KudoC0nan/Balance_On_Wheels/CAD_Designs/Prototype/Design.md

## Design Timeline
<h4>Old design for Case</h4>
<p>It contained curved structures and an additional platform on top for the SRA board<br>
Our second design was modeled in the same way and modified from there accordingly</p>
<image src="assets\Pic1.png"><br>

<p>The new changes made to the design were to make the surfaces flat and reduce the number of unncecssary structures that would cause manufacturing difficulties</p>
<image src="assets\Old.png"><br>
<p>The old leg design contained unneccesary curves which pu strain on their structure. Along with that the joints in the old design were not proper as well</p>
<image src="assets\Pic2.png"><br>
  <p>The motor used for this project is the N20 motor</p>
  <image src="assets\n20.png"><br>
    <p>We went with wheel used in our Wall-E project as wheels for this bot</p>
    <image src="assets\wheel.png"><br>
<p>Along with eliminating the curves, a sandwich leg design is implemented</p>
<image src="assets\bot.png"><br>
<p>New design with Flat casing</p>
<image src="assets\Top.png"><br>
