KudoC0nan/Balance_On_Wheels/Notes/Arsh Notes/pwm.md

# PWM (Pulse Width Modulation)
---
**Pulse-width modulation (PWM)**, or pulse-duration modulation (PDM), is a method of reducing the average power delivered by an electrical signal, by effectively chopping it up into discrete parts. 
Pulse Width Modulation, or PWM, is a technique for getting analog results with digital means. 
The average value of voltage (and current) fed to the load is controlled by turning the switch between supply and load on and off at a fast rate. The longer the switch is on compared to the off periods, the higher the total power supplied to the load.



#Terms Related to PWM


There are various terms related with the Pulse Width Modulation:-

**Off-Time**
 Duration of time period when the signal is low.
**ON-Time** 
Duration of time period when the signal is high.
**Duty cycle** 
It is the percentage of the time period when the signal remains ON during the period of the pulse width modulation signal.
**Period** 
It is the sum of off-time and on-time of pulse width modulation signal.

## Duty Cycle
Duty cycle is the ratio of time a load or circuit is ON compared to the time the load or circuit is OFF. Duty cycle, sometimes called "duty factor," is expressed as a percentage of ON time. 


Example : A 60% duty cycle is a signal that is ON 60% of the time and OFF the other 40% of time.

Duty Cycle Examples

## Period
Period is a sum of both on and off times and period is calculated as shown in the equation below, where Toff represents the off-time and Ton represents the on-time of a signal.
Formula for calculating Period

#Applications of PWM
**PWM signals can be used for wide variety of applications**
1] PWM Techniques are used in Telecommunications for encoding purposes.

2] Pulse Width Modulation finds its use in controlling Brightness in Smart Lighting Systems 

3] PWM-controlled device that clamps down hard on something.

4] Pin PWM header fan that helps to dissipate the heat from the motherboard.

5] Using the PWM technique and the switching mechanism we can control analog using the digital signal.

6] Pulse Width Modulation is also used to controls the speed of motors.
    (The speed of a DC motor can be controlled by varying its input voltage, i.e. by using PWM.The higher the duty cycle, the greater the average voltage being applied to the dc motor(High Speed) and the lower the duty cycle, the less the average voltage being applied to the dc motor(Low Speed)).

7] Pulse Width Modulation is used as a Volatge Regulator



## Types of PWM
**1] Light Emitting Diode PWM (LEDPWM)**
LEDPWM has low and high speed mode and provides low (8-bit) resolution.

**2] Motor Controlled PWM (MCPWM)**
MCPWM has limited speed and provides high(16-bit) resolution.
Which means that mcpwm will count from 0 to (2^16)-1 in 1 sec i.e. 0 to 65535 in 1 sec.
It has two MCPWM peripherals. Each has 3 pairs of pwm output and can be used to control various types of motors.

![]()

---
#CODE

```C
#include <stdio.h>
#include <math.h>
#include <time.h>
#include <string.h>
#include <stdlib.h>

//Components
#include "sra_board.h"

// Select the mode needed by uncommenting its definition
#define MODE NORMAL_MODE
// #define MODE PARALLEL_MODE

void pwm_task(void *arg)
{

	if (MODE == NORMAL_MODE)
	{
		enable_motor_driver(a, NORMAL_MODE); // Enable motor driver A in Normal Mode

		// Make the Motors go forward & backward alternatively, at different PWM from 60 to 100
		while (1)
		{
			for (int duty_cycle = 60; duty_cycle <= 100; duty_cycle++)
			{
				// setting motor speed of MOTOR A0 in forward direction with duty cycle
				set_motor_speed(MOTOR_A_0, MOTOR_FORWARD, duty_cycle);

				// setting motor speed of MOTOR A1 in forward direction with duty cycle
				set_motor_speed(MOTOR_A_1, MOTOR_FORWARD, duty_cycle);

				// adding delay of 100ms
				vTaskDelay(100 / portTICK_PERIOD_MS);
			}

			// stopping the MOTOR A0
			set_motor_speed(MOTOR_A_0, MOTOR_STOP, 0);

			// stopping the MOTOR A1
			set_motor_speed(MOTOR_A_1, MOTOR_STOP, 0);

			// adding delay of 100ms
			vTaskDelay(100 / portTICK_PERIOD_MS);

			for (int duty_cycle = 60; duty_cycle <= 100; duty_cycle++)
			{
				// setting motor speed of MOTOR A0 in backward direction with duty cycle
				set_motor_speed(MOTOR_A_0, MOTOR_BACKWARD, duty_cycle);

				// setting motor speed of MOTOR A1 in backward direction with duty cycle
				set_motor_speed(MOTOR_A_1, MOTOR_BACKWARD, duty_cycle);

				// adding delay of 100ms
				vTaskDelay(100 / portTICK_PERIOD_MS);
			}

			// stopping the MOTOR A0
			set_motor_speed(MOTOR_A_0, MOTOR_STOP, 0);

			// stopping the MOTOR A1
			set_motor_speed(MOTOR_A_1, MOTOR_STOP, 0);

			// adding delay of 100ms
			vTaskDelay(100 / portTICK_PERIOD_MS);
		}
	}

	else if (MODE == PARALLEL_MODE)
	{
		enable_motor_driver(a, PARALLEL_MODE); // Enable motor driver A in Parallel Mode

		// Make the Motors go forward & backward alternatively, at different PWM from 60 to 100
		while (1)
		{
			for (int duty_cycle = 60; duty_cycle <= 100; duty_cycle++)
			{
				// setting motor speed of motor A in forward direction with duty cycle
				set_motor_speed(MOTOR_A_0, MOTOR_FORWARD, duty_cycle);

				// adding delay of 100ms
				vTaskDelay(100 / portTICK_PERIOD_MS);
			}

			// stopping the motor A
			set_motor_speed(MOTOR_A_0, MOTOR_STOP, 0);

			// adding delay of 100ms
			vTaskDelay(100 / portTICK_PERIOD_MS);

			for (int duty_cycle = 60; duty_cycle <= 100; duty_cycle++)
			{
				// setting motor speed of motor A in backward direction with duty cycle
				set_motor_speed(MOTOR_A_0, MOTOR_BACKWARD, duty_cycle);

				// adding delay of 100ms
				vTaskDelay(100 / 10);
			}

			// stopping the motor A
			set_motor_speed(MOTOR_A_0, MOTOR_STOP, 0);

			// adding delay of 100ms
			vTaskDelay(100 / portTICK_PERIOD_MS);
		}
	}
}
void app_main()
{
	// Basic Function for task creation
	xTaskCreate(&pwm_task, "pwm_task", 4096, NULL, 1, NULL);
}
```
## Expalanation

In `components/sra-board-component/src/motor_driver.c` you can see that the frequency is set to be 20KHz.
In the example duty cycle goes from 60 to 100 and then 0 and then from 60 to 100 in opposite direction for both  the modes.
For one pulse it takes 1/20 KHz secs i.e. 5x10^-5 sec (50 µs) 60% duty cycle means it will be on for 3x10^-5 sec  (30 µs ) and off for 100/(80 x 10^-6 ) i.e 1.25 µs + 20 µs .In the next iteration the value of duty cycle increases and in the last it becomes 100 % which means that signal is high for 5  µs and then a delay again for 1.25 µs. Same in opposite direction.

---

## Header Files

1] `#include<math.h>`
The math.h header defines various mathematical functions and one macro. 
2] `#include <time.h>`
The time.h header defines four variable types, two macro and various functions for manipulating date and time.
3] `#include <string.h>`
The string.h header defines one variable type, one macro, and various functions for manipulating arrays of characters.
4] `#include <stdlib.h>`
The stdlib.h header defines four variable types, several macros, and various functions for performing general functions.
5] `include "sra_board.h"`
Includes components of Sra Board
6] `#define MODE NORMAL_MODE`
Defining a macro, mode as normal_mode

## Functions

1] `enable_motor_driver(a,NORMAL_MODE) or enable_motor_driver(a,NORMAL_MODE)`

`esp_err_t enable_motor_driver_a(int mode)`	

Enables Motor driver A in Parallel or Normal Mode.

**Parameters**
mode : if mode = 1 is passed, motor driver is operated in parallel mode, if mode = 2 is passed, motor driver is operated in normal mode

**Returns** 
esp_err_t returns ESP_OK if motor driver initialised properly, else it returns ESP_ERR_INVALID_ARG

`esp_err_t enable_motor_driver_b(int mode)`	

Enables Motor driver B in Parallel or Normal Mode.

**Parameters**
mode : if mode = 1 is passed, motor driver is operated in parallel mode, if mode = 2 is passed, motor driver is operated in normal mode

**Returns** 
esp_err_t returns ESP_OK if motor driver initialised properly, else it returns ESP_ERR_INVALID_ARG

2] `set_motor_speed()`

Set the speed of motors.

**Syntax**
`esp_err_t set_motor_speed (int motor_id,int direction,float duty_cycle)`
 
**Parameters**
motor_id : set it as MOTOR_A_0, MOTOR_A_1, MOTOR_B_0, MOTOR_B_1 to select the appropriate motor to set its speed and direction

direction : set is as MOTOR_FORWARD for forward motion, MOTOR_BACKWARD for backward motion, MOTOR_STOP to stop the motor

duty_cycle : set the duty cycle of the motor driver PWM

**Returns** 
esp_err_t returns ESP_OK if speed correctly, ESP_FAIL if any error occurs

3] `xTaskCreate()`
Create a new task and add it to the list of tasks that are ready to run.
Each task requires RAM that is used to hold the task state, and used by the task as its stack. If a task is created using xTaskCreate() then the required RAM is automatically allocated from the FreeRTOS heap. 

Example:
``` C
void app_main()
{
    nvs_flash_init();
    xTaskCreate(&hello_task,"hello_task",2040,NULL,5,NULL);

}
```
This function takes 5 arguments. Forget the NULL ones for now. The first parameter is address of the function which execute, when this task is scheduled to run!. The second parameter hello_task is the name given to the task and this could be any name. It used to obtain handle or while debugging the task. The next parameter 2048 is the memory allocated to the task in word (2 Bytes).The next paramater is task priority.

4] `vTaskDelay()`

This function helps us delay a task by a specified amount of time.The actual time that the task remains blocked depends on the tick rate.The constant `portTICK_PERIOD_MS` can be used to calculate real time from the tick rate - with the resolution of one tick period.
    
    Example :
    vTaskDelay(1000 / portTICK_PERIOD_MS)
    PortTICK_PERIOD_MS = 10ms
    1000 / portTICK_PERIOD_MS = 100 ticks
    100 * 10ms = 1 sec
    Therefore a delay of 1 sec.

# Normal Mode VS Parallel Mode

 


A Motor driver can control 2 motors. In normal mode motor driver controls 2 motors at a time giving a maximum current capacity of 1.2A to each motor.
Whereas in parallel mode the motor driver controls a single motor giving a max current capacity of 2.4A to single motor
Parallel mode is used for motors which require high current (Motors with Heavy Current Consumption)

## Motor Driver 

In our SRA Board we are using **TB6612FNG Motor Driver**.


In simplest terms, Motor Drivers are current amplifiers.
Their function  is to take a low-current control signal, and turn it into a  proportionally higher-current signal that can drive a motor.

The TB6612FNG H-Bridge is a small and inexpensive dual-channel H-Bridge controller. In this type of motor driver all of the input pins are on one side and all of the output and power pins are on the other side.  

## Minimum Duty Cycle Required

Minimum Duty Cycle required for rotation of single or both motor is around 50-55% Duty Cycle.
Minimum Duty Cycle is required to overcome the Frictional Forces (Static).
Once the Duty Cycle passes the Threshold Value, it is able to Static Frictional Forces and due to inertia the motor rotates for long period of time.
