KudoC0nan/Balance_On_Wheels/assets/Balance_On_Wheels.jpeg

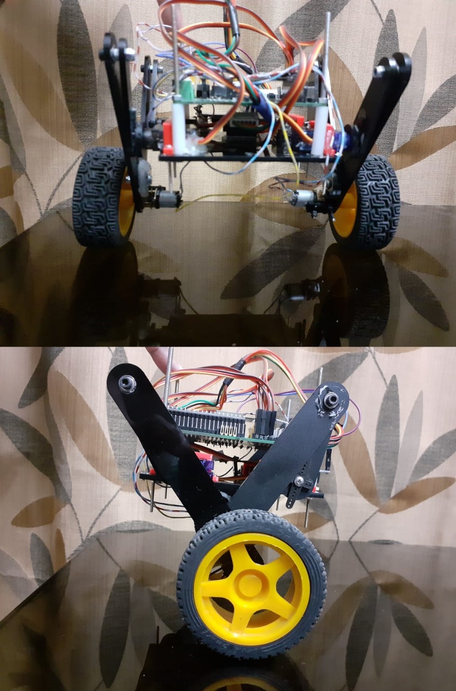
assets/Balance_On_Wheels.jpeg
