KudoC0nan/Balance_On_Wheels/assets/pid.png

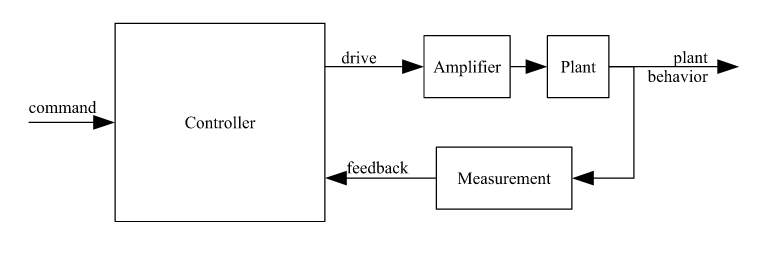
assets/pid.png
