KudoC0nan/Balance_On_Wheels/CAD_Designs/Intermidiate Design/5mm bot/motor mount dim.png

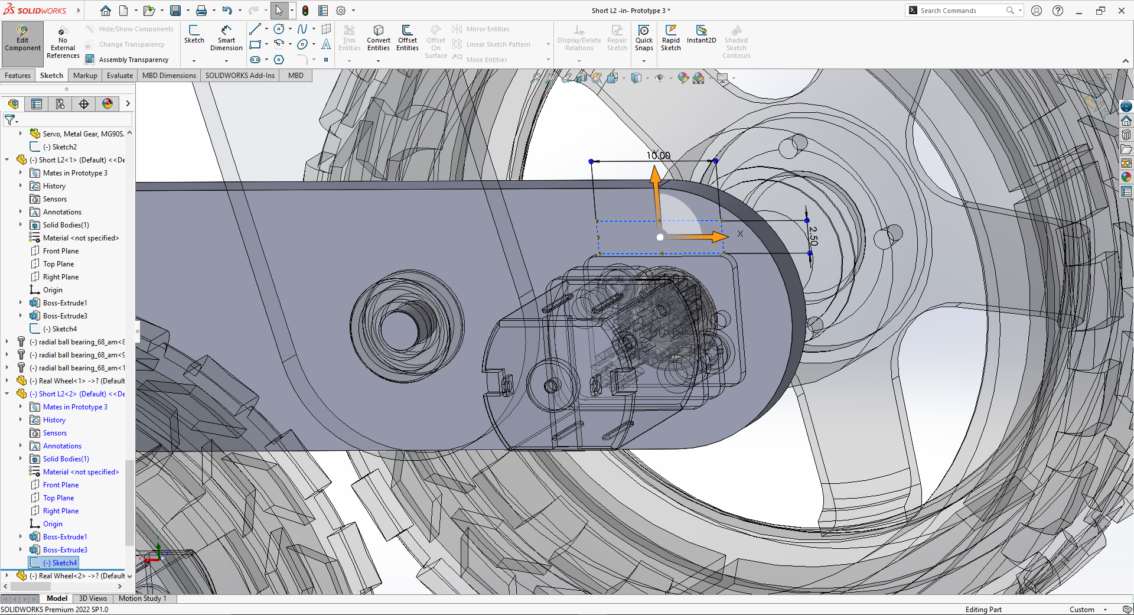
CAD_Designs/Intermidiate Design/5mm bot/motor mount dim.png
