KudoC0nan/Balance_On_Wheels/CAD_Designs/Intermidiate Design/5mm bot/Motor mount extruded from leg.png

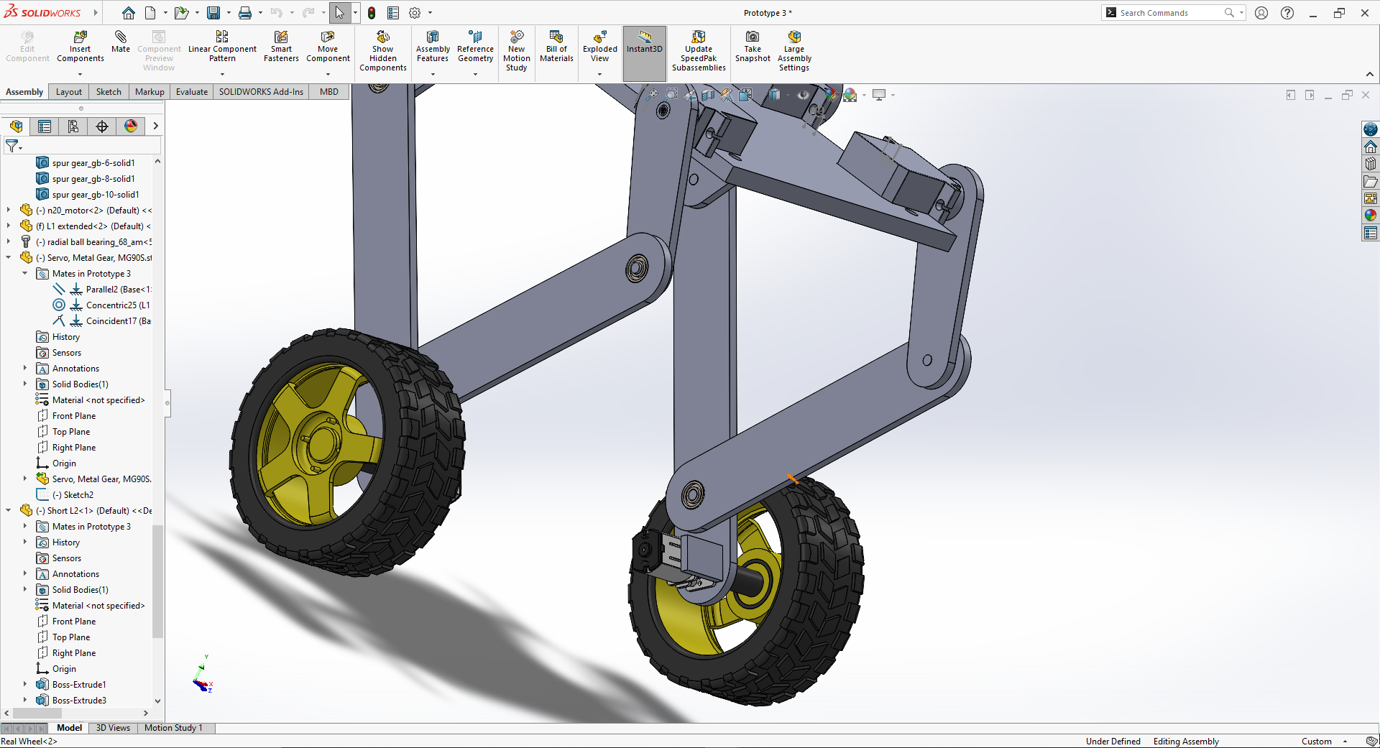
CAD_Designs/Intermidiate Design/5mm bot/Motor mount extruded from leg.png
