KudoC0nan/Balance_On_Wheels/CAD_Designs/Intermidiate Design/5mm(cut extrude n20 mount)/cut extuded n20 mount.png

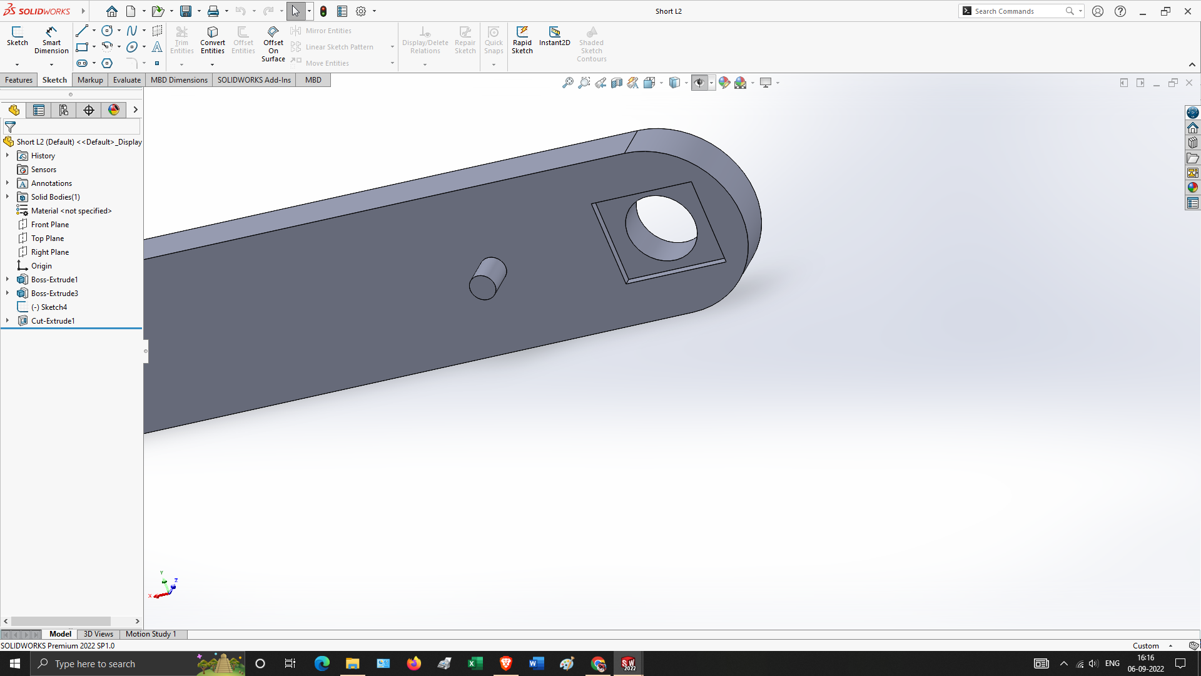
CAD_Designs/Intermidiate Design/5mm(cut extrude n20 mount)/cut extuded n20 mount.png
