KudoC0nan/Balance_On_Wheels/CAD_Designs/Intermidiate Design/Servo mount 1/Motor mount pic 3.png

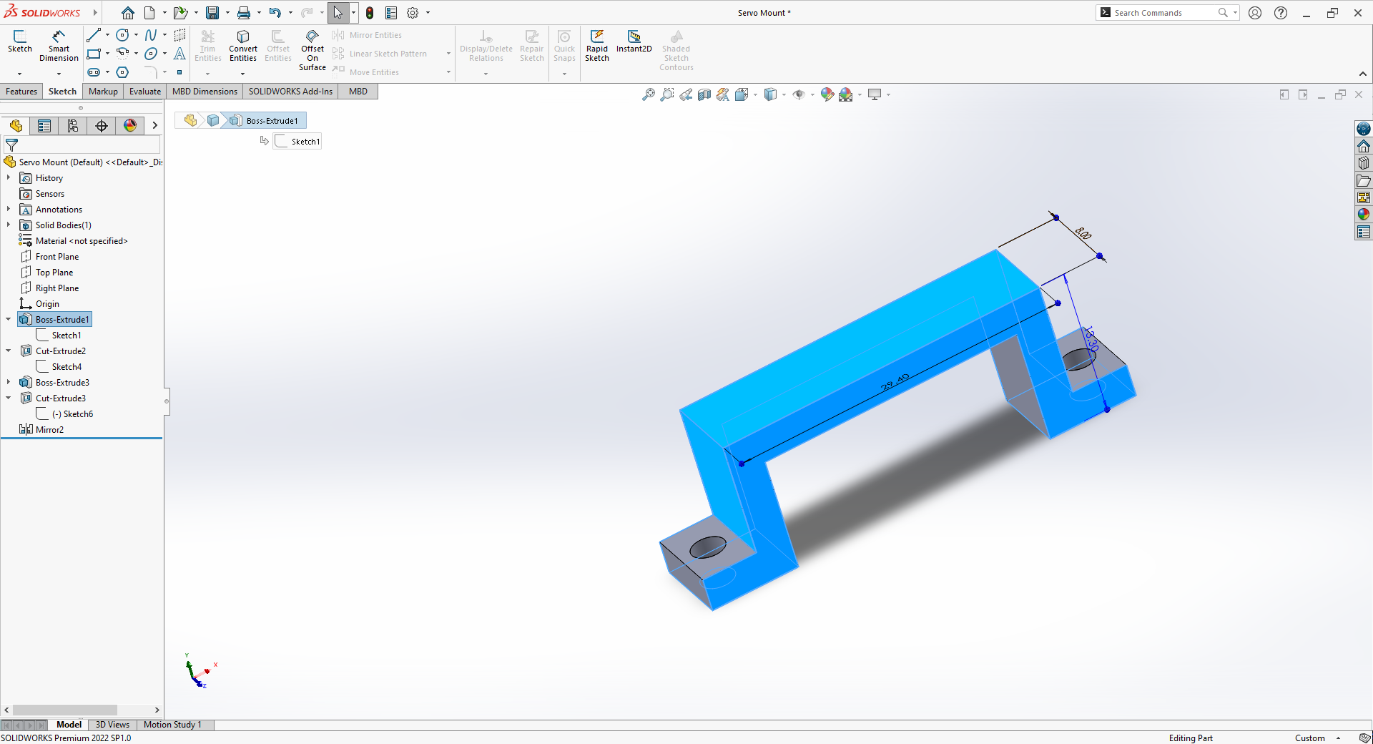
CAD_Designs/Intermidiate Design/Servo mount 1/Motor mount pic 3.png
