KudoC0nan/Balance_On_Wheels/CAD_Designs/Prototype/assets/bot.png

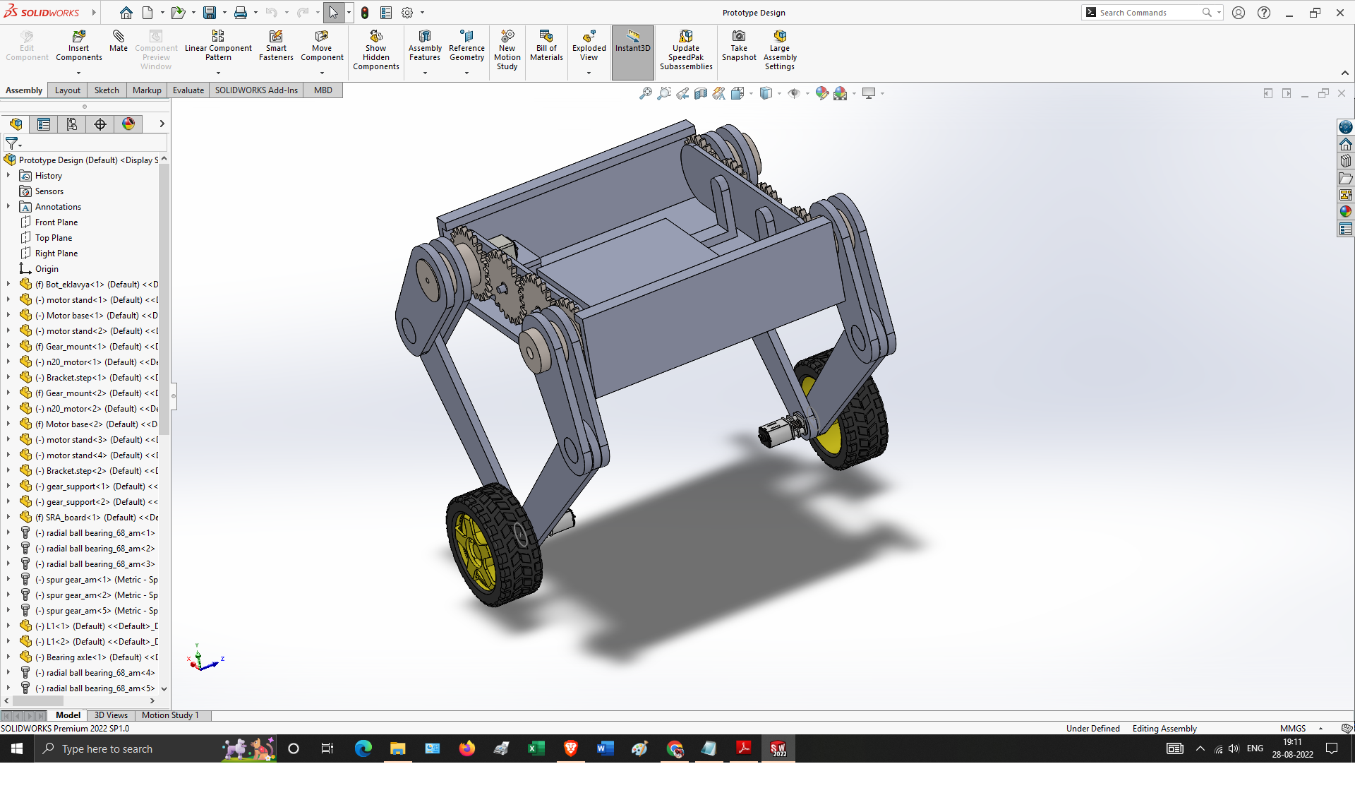
CAD_Designs/Prototype/assets/bot.png
