KudoC0nan/Balance_On_Wheels/CAD_Designs/Prototype/assets/n20.png

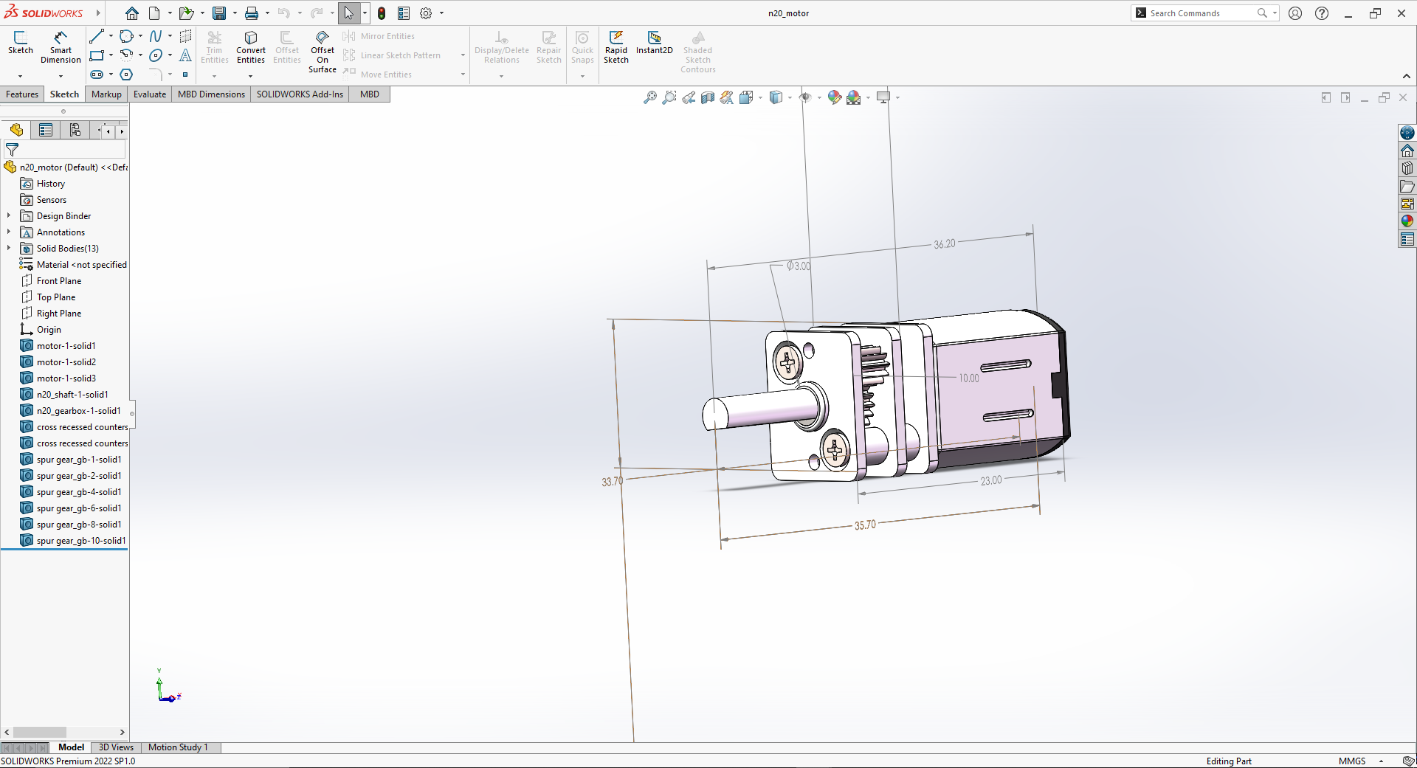
CAD_Designs/Prototype/assets/n20.png
