KudoC0nan/Balance_On_Wheels/CAD_Designs/Prototype/assets/Top.png

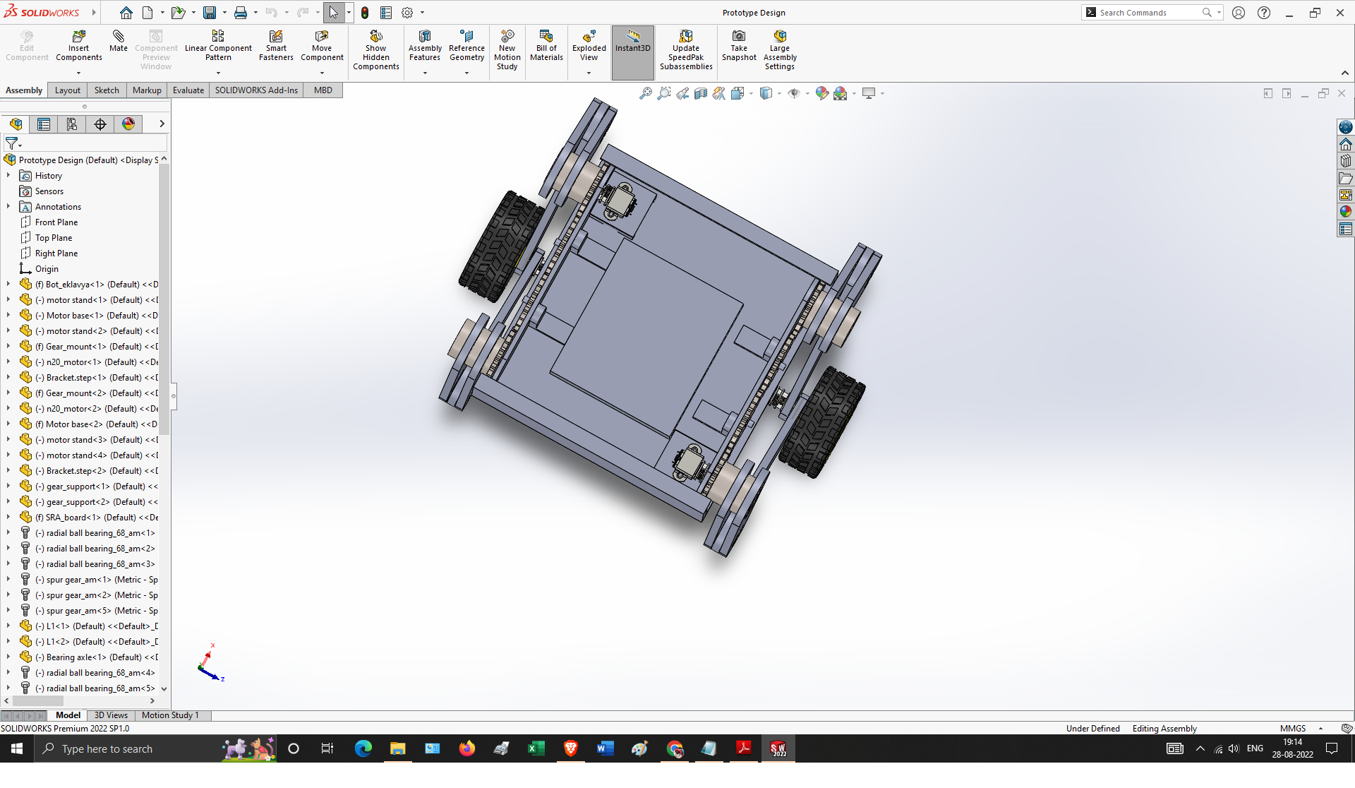
CAD_Designs/Prototype/assets/Top.png
