KudoC0nan/Balance_On_Wheels/CAD_Designs/Prototype/assets/wheel.png

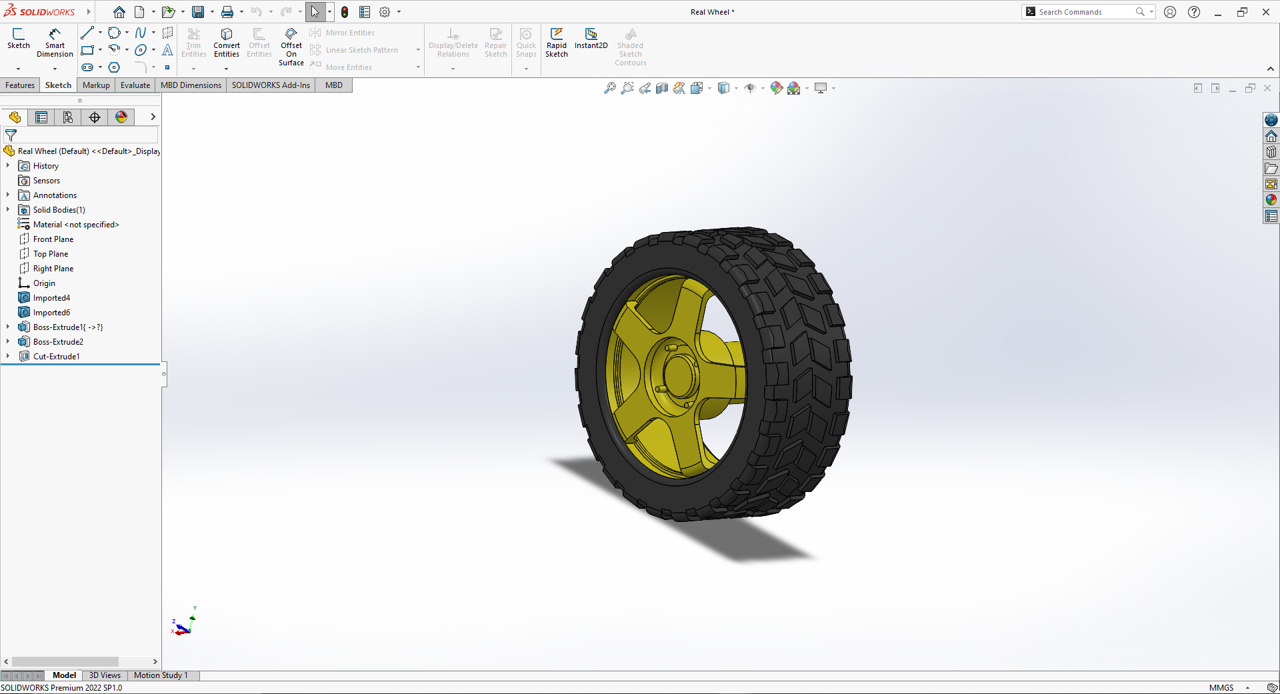
CAD_Designs/Prototype/assets/wheel.png
