KudoC0nan/Balance_On_Wheels/CAD_Designs/Prototype 2/Prototype 2.SLDASM

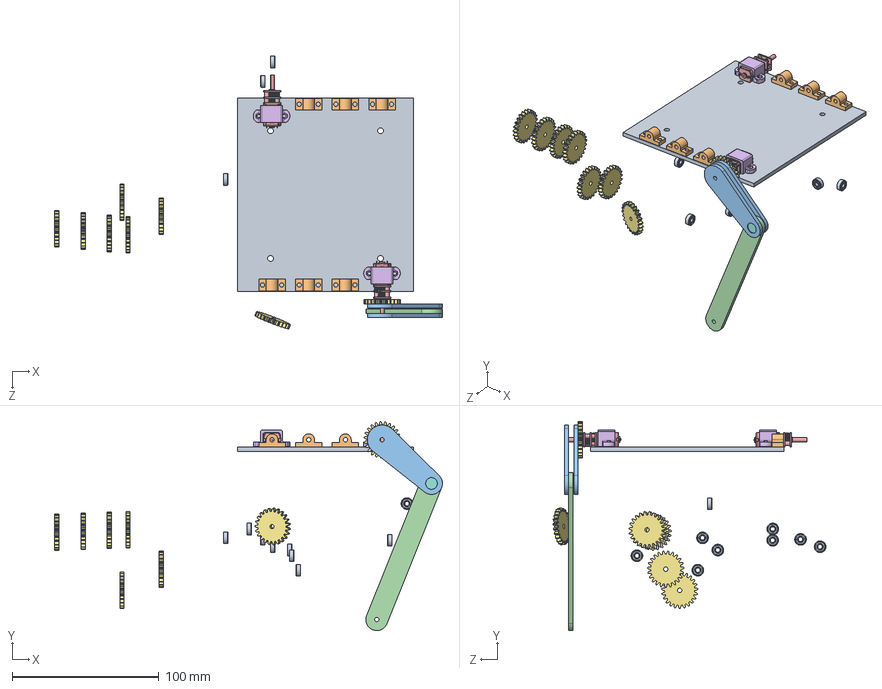
[picture p43: CAD file, 2022-10-15]
CAD_Designs/Prototype 2/Prototype 2.SLDASM
264.5 x 142.6 x 186.1 mm
Base
Gear mount x 6
L1 new x 2
L2 new
n20_motor x 2
Bracket.step x 2
spur gear_am x 8
Axle
radial ball bearing_68_am x 10
