KudoC0nan/Balance_On_Wheels/CAD_Designs/Prototype/Design File/Prototype Design.SLDASM

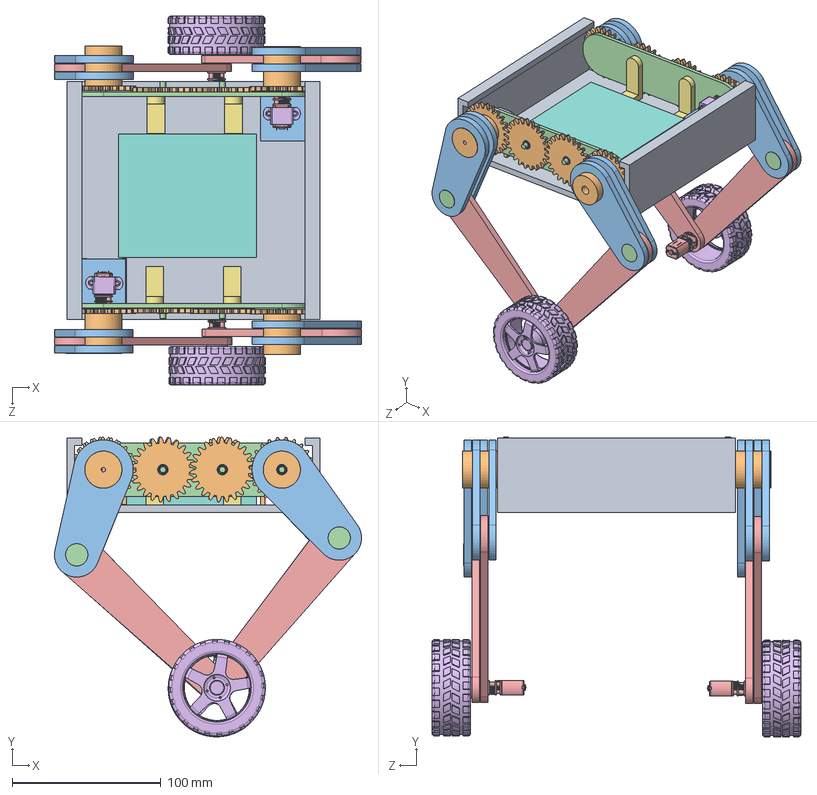
[picture p44: CAD file, 2022-10-15]
CAD_Designs/Prototype/Design File/Prototype Design.SLDASM
206.5 x 201.6 x 248.1 mm
Bot_eklavya
motor stand x 4
Motor base x 2
Gear_mount x 2
n20_motor x 4
Bracket.step x 2
gear_support x 4
SRA_board
radial ball bearing_68_am x 10
spur gear_am x 8
L1 x 8
Bearing axle x 4
Updated Leg Design 1 x 4
Real Wheel x 2
