KudoC0nan/Balance_On_Wheels/CAD_Designs/Final Design For Laser Cut (3mm)/3mm/Prototype 3 (fully 3 mm).SLDASM

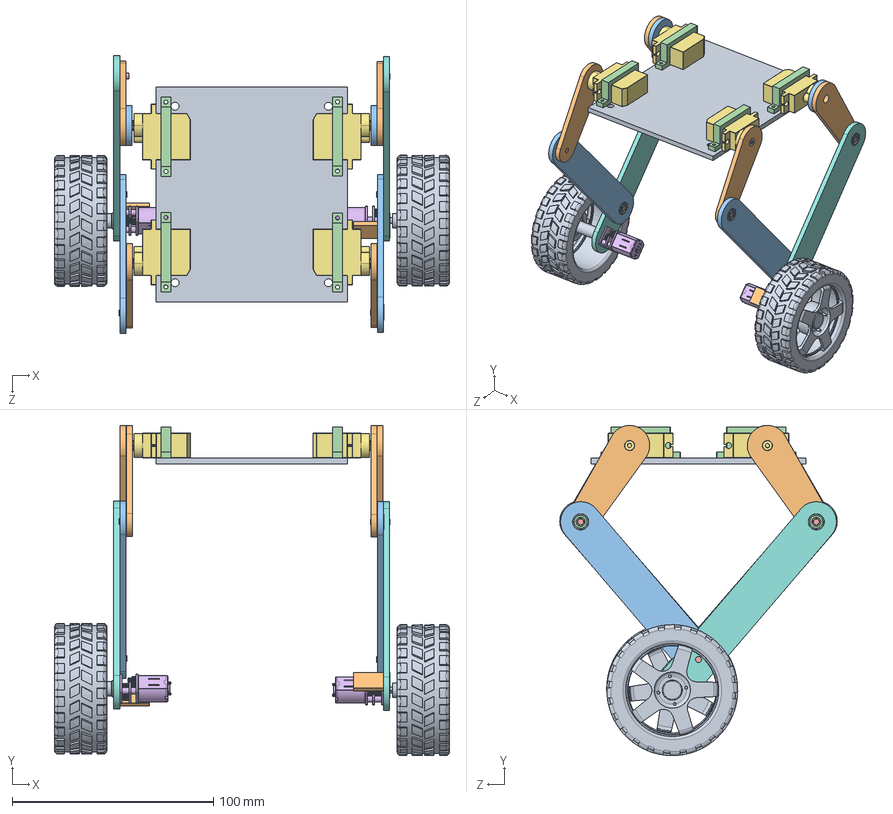
[picture p45: CAD file, 2022-10-15]
CAD_Designs/Final Design For Laser Cut (3mm)/3mm/Prototype 3 (fully 3 mm).SLDASM
196.2 x 164.0 x 137.8 mm
Base 3mm thick
L1 new(3mm) x 4
L2 new(3mm) x 2
radial ball bearing_68_am x 8
Axle for joint(3mm) x 6
n20_motor(3mm) x 2
Servo, Metal Gear, MG90S.step(3mm) x 4
Long L2(3mm) x 2
Real Wheel(3mm) x 2
motor mount(3mm) x 2
L1 extension(3mm) x 2
Servo Mount(3mm) x 4
