KudoC0nan/Balance_On_Wheels/CAD_Designs/Design For Lasercut (5mm)/5mm bot/Prototype 3 (fully 5 mm).SLDASM

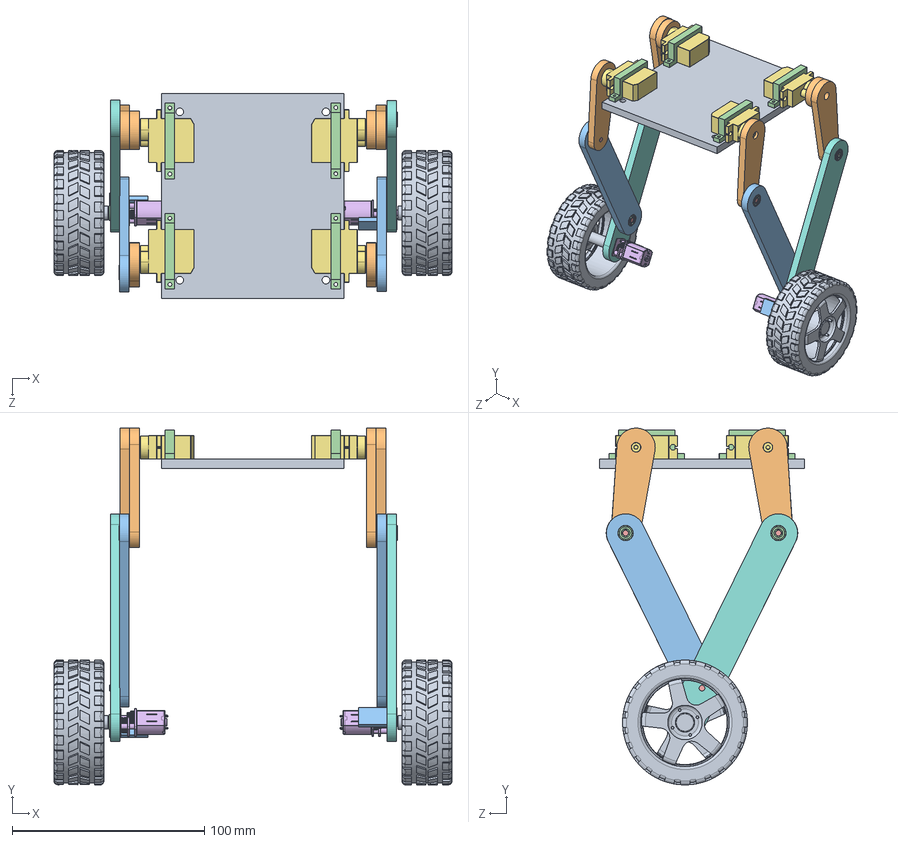
[picture p46: CAD file, 2022-10-15]
CAD_Designs/Design For Lasercut (5mm)/5mm bot/Prototype 3 (fully 5 mm).SLDASM
207.3 x 185.8 x 107.0 mm
Base 5 mm thick
L1 new(5 mm) x 4
L2 new(5mm) x 2
radial ball bearing_68_am x 8
axle 10mm x 6
n20_motor x 2
Servo, Metal Gear, MG90S.step x 4
L2 long(5mm) x 2
Real Wheel x 2
L1 extension 5mm x 2
motor mount x 2
Servo Mount x 4
