KudoC0nan/Balance_On_Wheels/CAD_Designs/Prototype/Design File/New_ASSEM (2).SLDASM

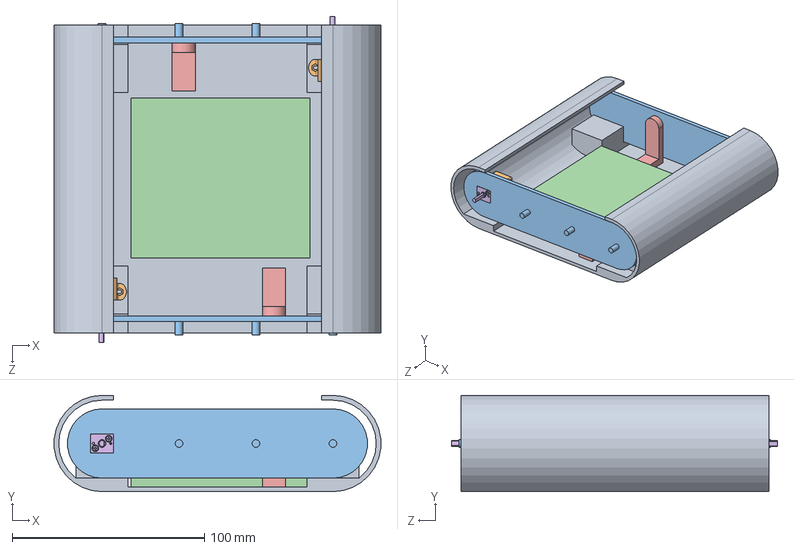
[picture p47: CAD file, 2022-10-15]
CAD_Designs/Prototype/Design File/New_ASSEM (2).SLDASM
169.7 x 50.0 x 169.4 mm
Bot eklavya
Bracket.step x 2
Gear mount x 2
SRA board
gear support x 2
n20 motor x 2
