KudoC0nan/Balance_On_Wheels/CAD_Designs/Design For Lasercut (5mm)/5mm bot/Base 5 mm thick.SLDPRT

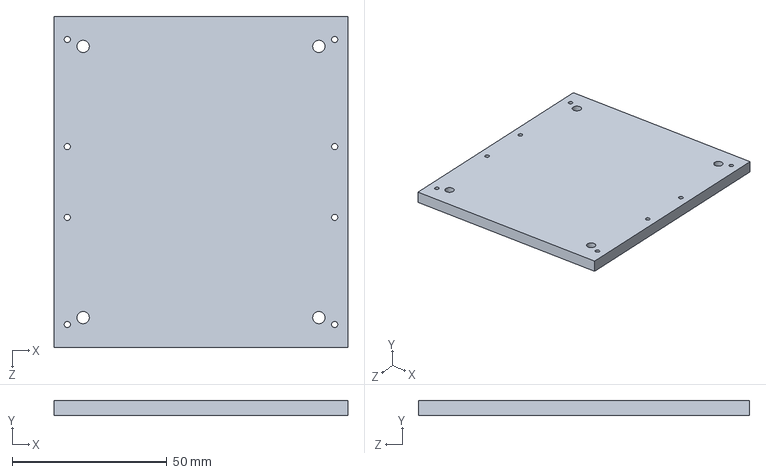
[picture p48: CAD file, 2022-10-15]
CAD_Designs/Design For Lasercut (5mm)/5mm bot/Base 5 mm thick.SLDPRT
95.0 x 5.00 x 107.0 mm
