KudoC0nan/Balance_On_Wheels/CAD_Designs/Final Design For Laser Cut (3mm)/3mm/Servo, Metal Gear, MG90S.step(3mm).SLDPRT

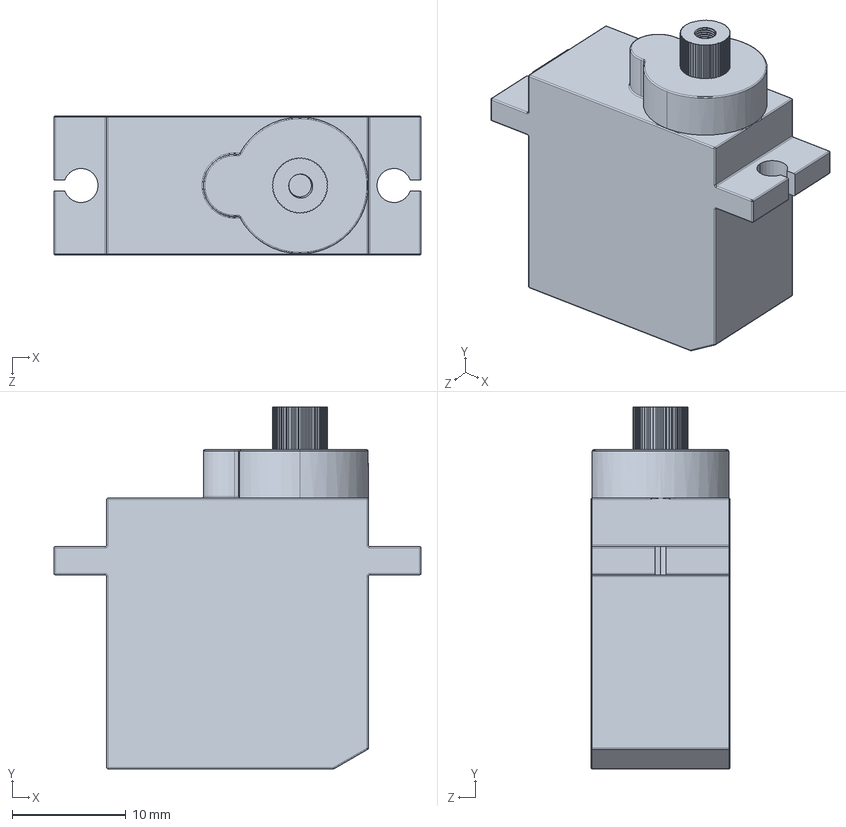
[picture p49: CAD file, 2022-10-15]
CAD_Designs/Final Design For Laser Cut (3mm)/3mm/Servo, Metal Gear, MG90S.step(3mm).SLDPRT
32.2 x 31.8 x 12.2 mm
