KudoC0nan/Balance_On_Wheels/CAD_Designs/Intermidiate Design/Servo mount 1/Servo Mount (og).SLDPRT

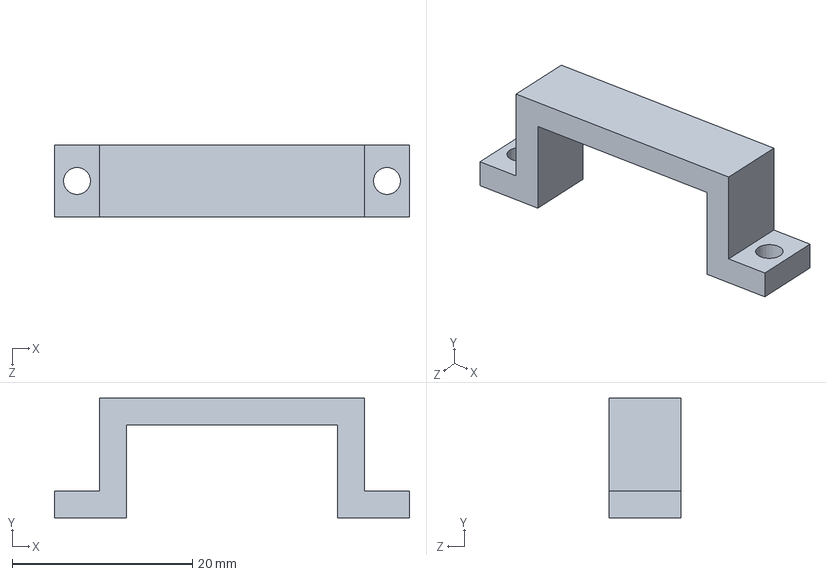
[picture p50: CAD file, 2022-10-15]
CAD_Designs/Intermidiate Design/Servo mount 1/Servo Mount (og).SLDPRT
39.4 x 13.3 x 8.00 mm
