KudoC0nan/Balance_On_Wheels/CAD_Designs/Prototype 2/p2 L2 new.SLDPRT

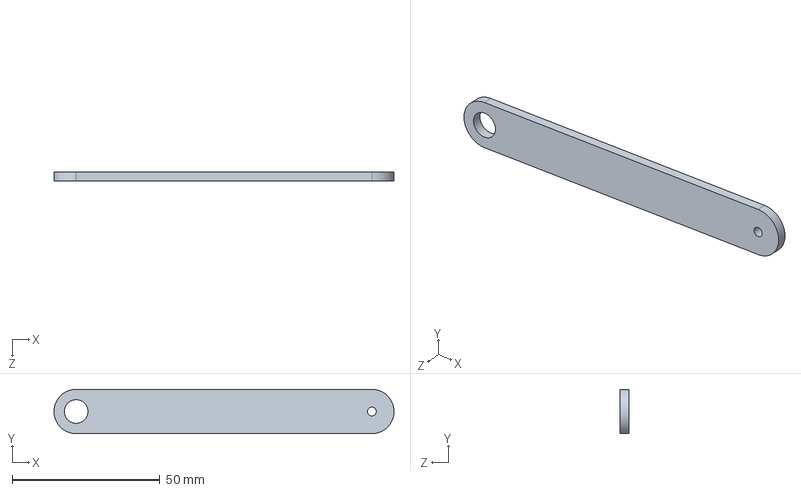
[picture p51: CAD file, 2022-10-15]
CAD_Designs/Prototype 2/p2 L2 new.SLDPRT
115.0 x 15.0 x 3.00 mm
