KudoC0nan/Balance_On_Wheels/CAD_Designs/Prototype/Design File/Leg Design L2.SLDPRT

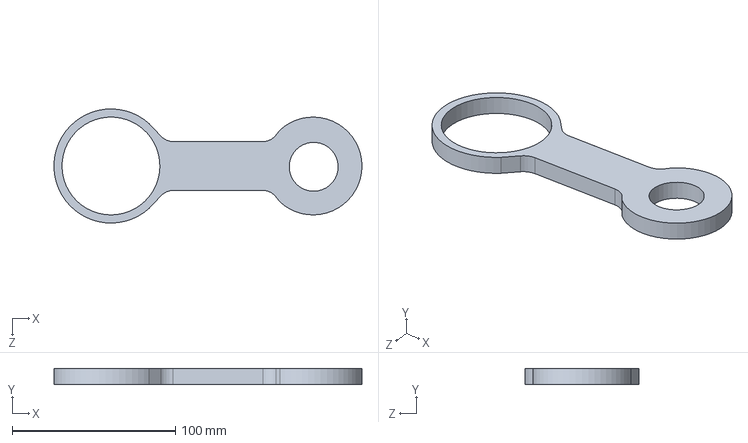
[picture p52: CAD file, 2022-10-15]
CAD_Designs/Prototype/Design File/Leg Design L2.SLDPRT
188.9 x 10.0 x 70.0 mm

components/sra-board-component/u8g2/sys/arduino/u8g2_full_buffer/SwitchBox/board.dxf
60
40
52
8
24
80
30
32
25
100
190
4
12
6
14

components/sra-board-component/u8g2/sys/arm/stm32l031x6/clock_2.dxf
65
Draufsicht
Vorderansicht
von unten
von rechts
von links
14
30
32
35
75
55
10
12
16
11
22
34
28
29
18
93
19
43
15
68
60
57
150
Holzbohrer: 2.5, 8, 10, 12, 16, 32mm
8
7
6
2.5mm
