KudoC0nan/Balance_On_Wheels/CAD_Designs/Prototype 2/Gear mount.SLDPRT

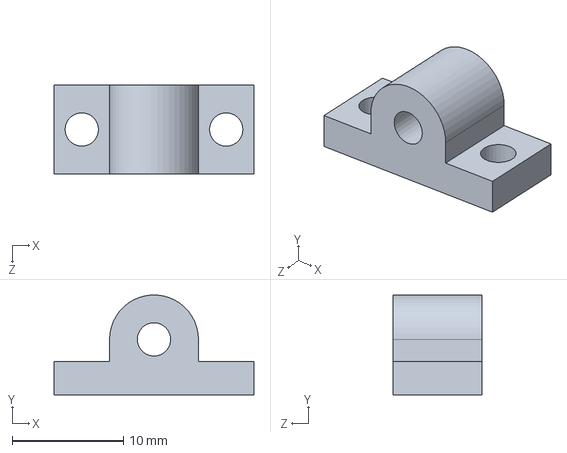
[picture p57: CAD file, 2022-10-15]
CAD_Designs/Prototype 2/Gear mount.SLDPRT
18.0 x 8.99 x 8.00 mm
