KudoC0nan/Balance_On_Wheels/CAD_Designs/Prototype/Design File/Bracket.step.SLDPRT

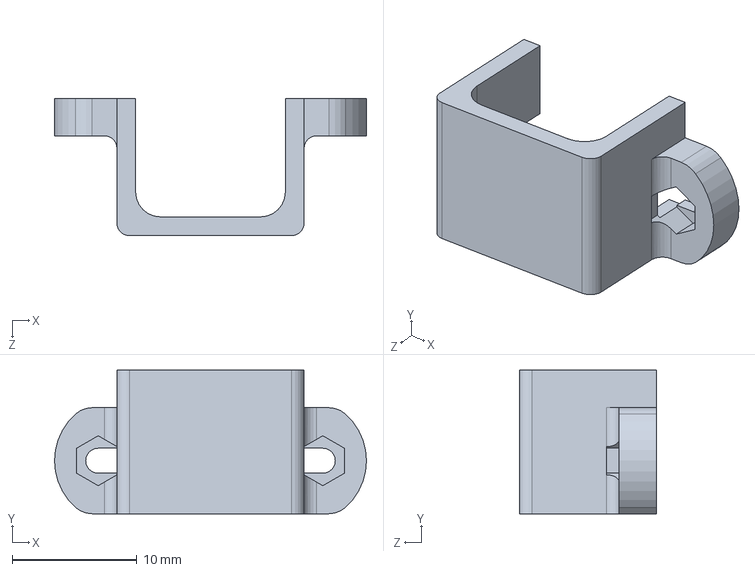
[picture p58: CAD file, 2022-10-15]
CAD_Designs/Prototype/Design File/Bracket.step.SLDPRT
25.0 x 11.5 x 11.0 mm
