KudoC0nan/Balance_On_Wheels/components/sra-board-component/u8g2/sys/arm/stm32l031x6/clock_cube.dxf

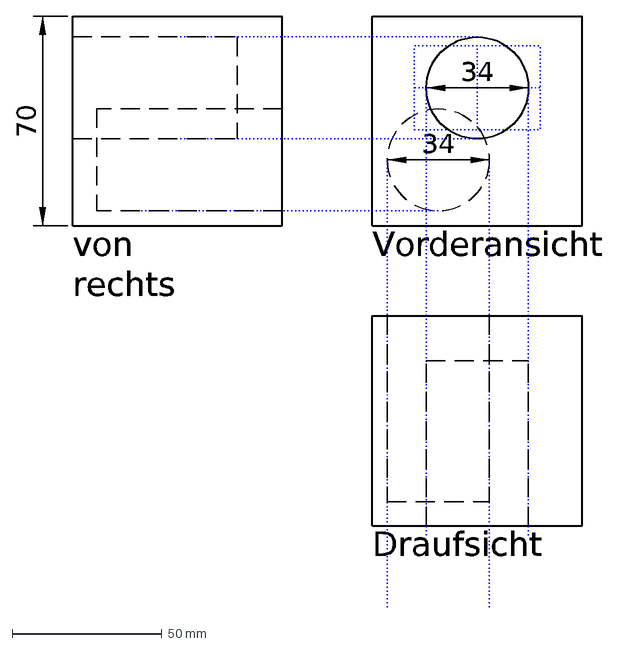
[picture p59: CAD file, 2022-10-15]
components/sra-board-component/u8g2/sys/arm/stm32l031x6/clock_cube.dxf
Draufsicht
Vorderansicht
von rechts
70
34
