KudoC0nan/Balance_On_Wheels/CAD_Designs/Final Design For Laser Cut (3mm)/3mm/Base 3mm thick.SLDPRT

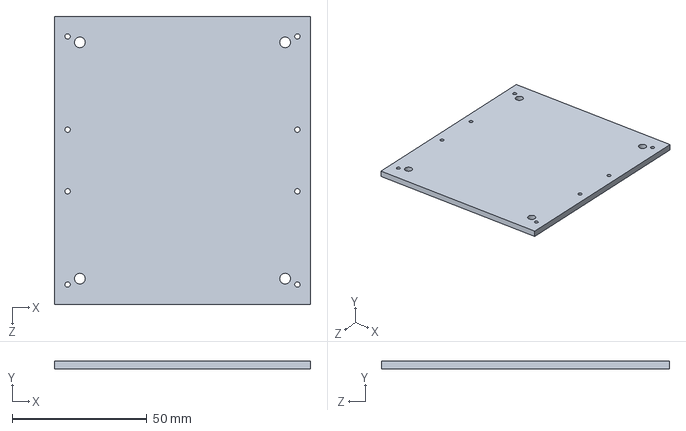
[picture p61: CAD file, 2022-10-15]
CAD_Designs/Final Design For Laser Cut (3mm)/3mm/Base 3mm thick.SLDPRT
95.0 x 3.00 x 107.0 mm
