KudoC0nan/Balance_On_Wheels/CAD_Designs/Prototype/Design File/L1.SLDPRT

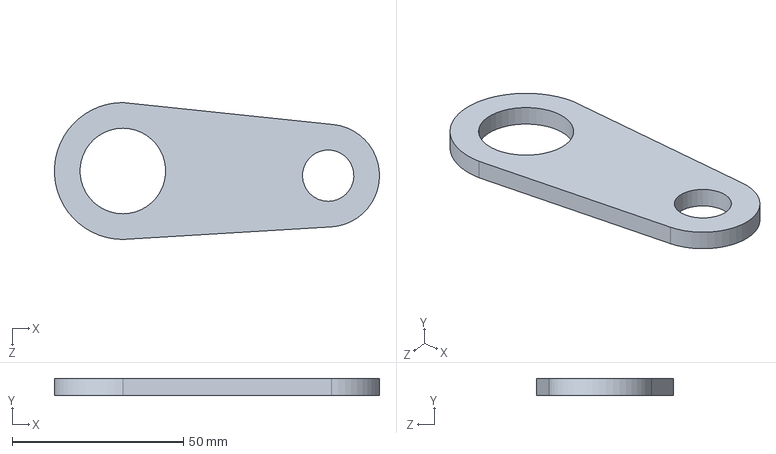
[picture p62: CAD file, 2022-10-15]
CAD_Designs/Prototype/Design File/L1.SLDPRT
94.9 x 5.00 x 40.0 mm

components/sra-board-component/u8g2/sys/arm/stm32l031x6/clock.dxf
65
32
28
16
Draufsicht
Vorderansicht
von unten
von rechts
von links
14
6
45
60
30
20
8
35
75
55
10
12
