KudoC0nan/Balance_On_Wheels/CAD_Designs/Design For Lasercut (5mm)/5mm bot/motor mount.SLDPRT

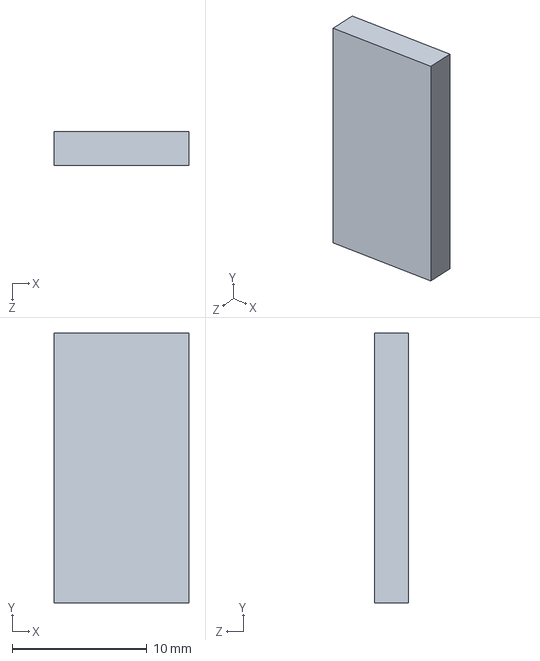
[picture p64: CAD file, 2022-10-15]
CAD_Designs/Design For Lasercut (5mm)/5mm bot/motor mount.SLDPRT
10.0 x 20.0 x 2.50 mm
