KudoC0nan/Balance_On_Wheels/CAD_Designs/Final Design For Laser Cut (3mm)/3mm/L1 extension(3mm).SLDPRT

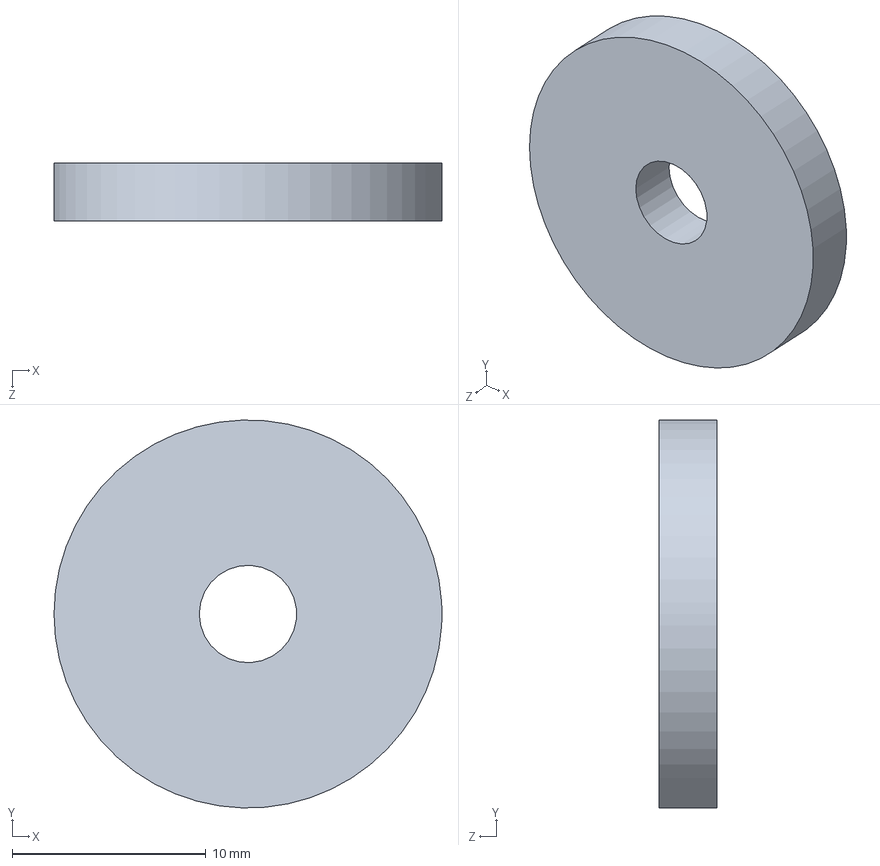
[picture p65: CAD file, 2022-10-15]
CAD_Designs/Final Design For Laser Cut (3mm)/3mm/L1 extension(3mm).SLDPRT
20.0 x 20.0 x 3.00 mm
