KudoC0nan/Balance_On_Wheels/CAD_Designs/Intermidiate Design/3 mm bot/oReal Wheel.SLDPRT

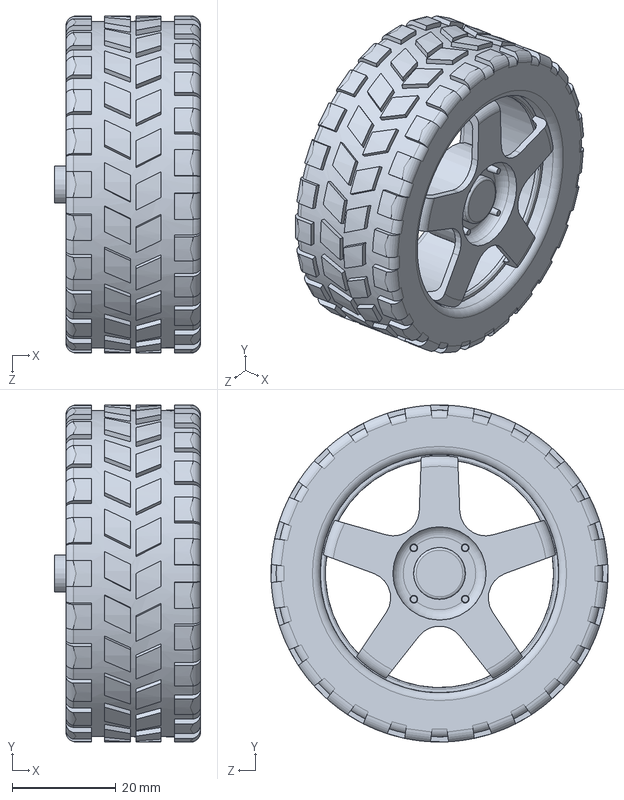
[picture p66: CAD file, 2022-10-15]
CAD_Designs/Intermidiate Design/3 mm bot/oReal Wheel.SLDPRT
28.2 x 65.0 x 65.0 mm
