KudoC0nan/Balance_On_Wheels/CAD_Designs/Prototype 2/p2 L1 new.SLDPRT

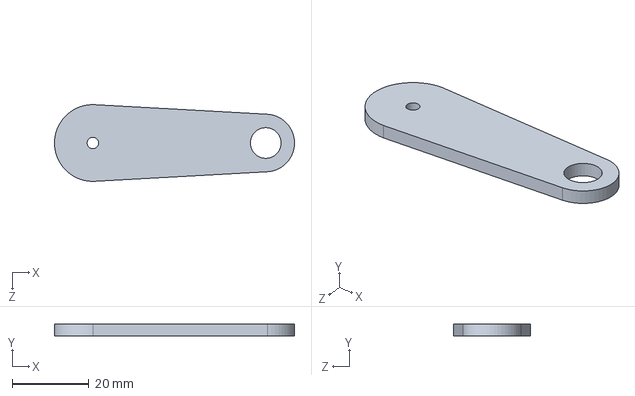
[picture p67: CAD file, 2022-10-15]
CAD_Designs/Prototype 2/p2 L1 new.SLDPRT
62.5 x 3.00 x 20.0 mm
