KudoC0nan/Balance_On_Wheels/CAD_Designs/Design For Lasercut (5mm)/5mm bot/Servo Mount.SLDPRT

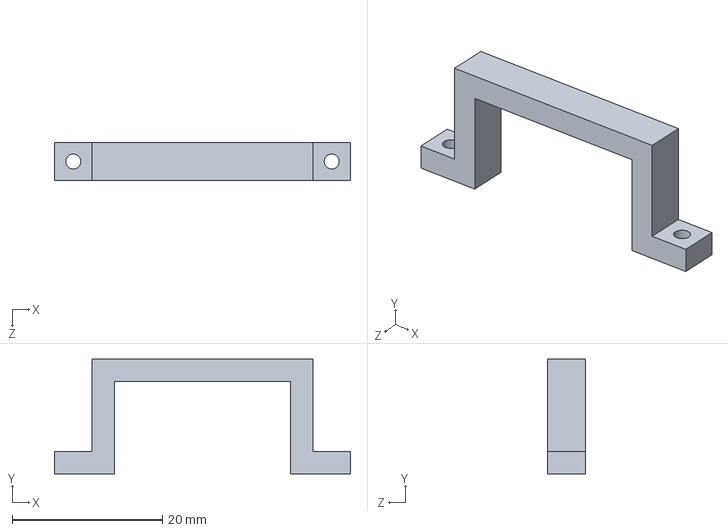
[picture p68: CAD file, 2022-10-15]
CAD_Designs/Design For Lasercut (5mm)/5mm bot/Servo Mount.SLDPRT
39.4 x 15.3 x 5.00 mm
