KudoC0nan/Balance_On_Wheels/CAD_Designs/Final Design For Laser Cut (3mm)/3mm/motor mount(3mm).SLDPRT

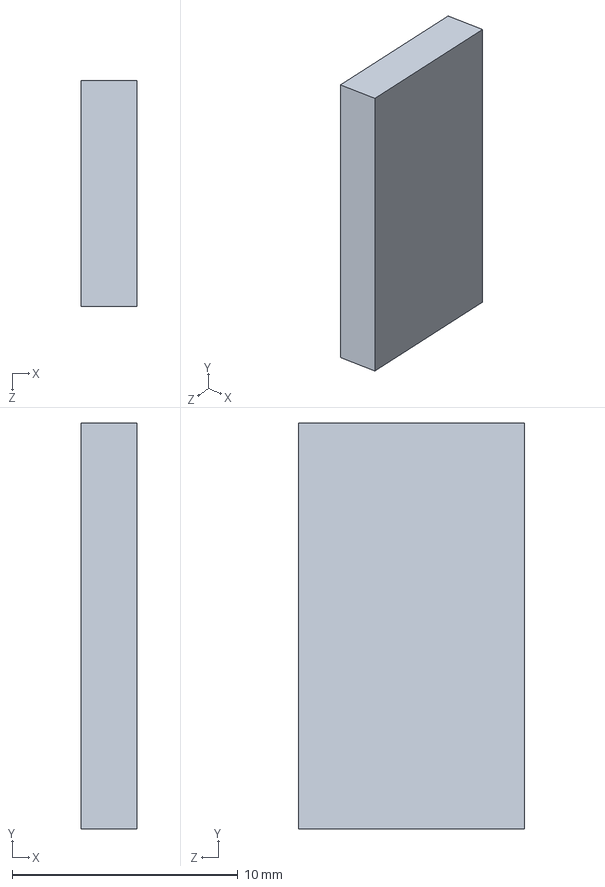
[picture p69: CAD file, 2022-10-15]
CAD_Designs/Final Design For Laser Cut (3mm)/3mm/motor mount(3mm).SLDPRT
2.50 x 18.0 x 10.0 mm
