KudoC0nan/Balance_On_Wheels/CAD_Designs/Intermidiate Design/5mm bot/On20_motor.SLDPRT

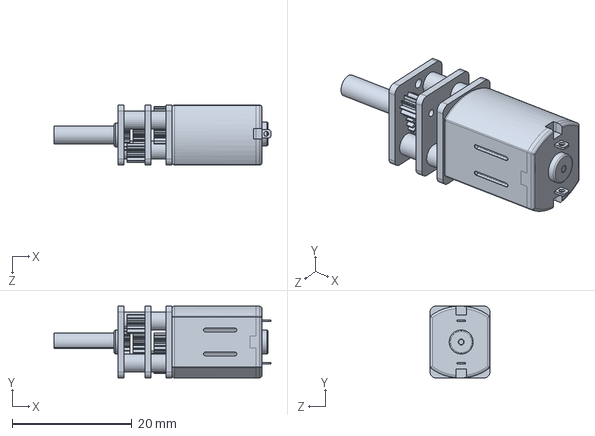
[picture p70: CAD file, 2022-10-15]
CAD_Designs/Intermidiate Design/5mm bot/On20_motor.SLDPRT
36.2 x 12.0 x 10.0 mm
