KudoC0nan/Balance_On_Wheels/CAD_Designs/Prototype 2/Axle.SLDPRT

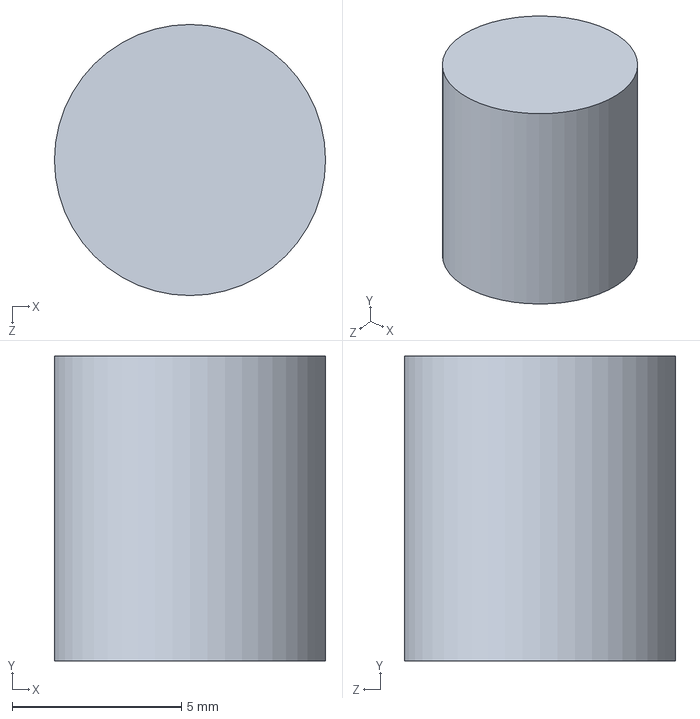
[picture p71: CAD file, 2022-10-15]
CAD_Designs/Prototype 2/Axle.SLDPRT
8.00 x 9.00 x 8.00 mm
