KudoC0nan/Balance_On_Wheels/CAD_Designs/Design For Lasercut (5mm)/5mm bot/axle 10mm.SLDPRT

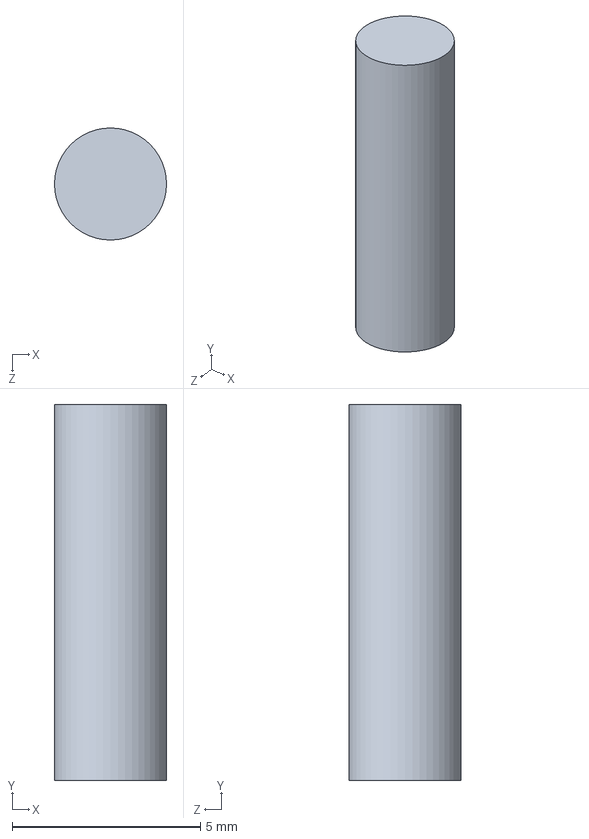
[picture p72: CAD file, 2022-10-15]
CAD_Designs/Design For Lasercut (5mm)/5mm bot/axle 10mm.SLDPRT
2.98 x 10.0 x 2.98 mm
