KudoC0nan/Balance_On_Wheels/CAD_Designs/Final Design For Laser Cut (3mm)/3mm/Axle for joint(3mm).SLDPRT

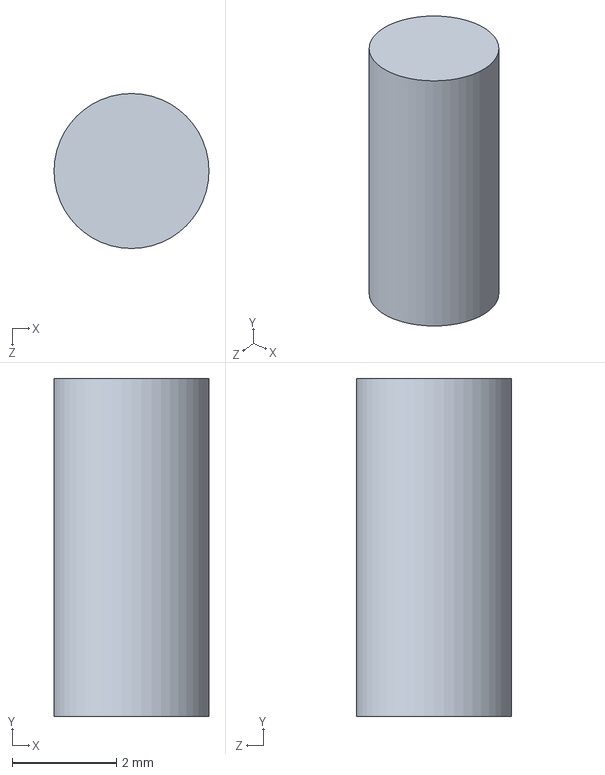
[picture p73: CAD file, 2022-10-15]
CAD_Designs/Final Design For Laser Cut (3mm)/3mm/Axle for joint(3mm).SLDPRT
2.98 x 6.50 x 2.98 mm
