KudoC0nan/Balance_On_Wheels/CAD_Designs/Prototype 2/Base.SLDPRT

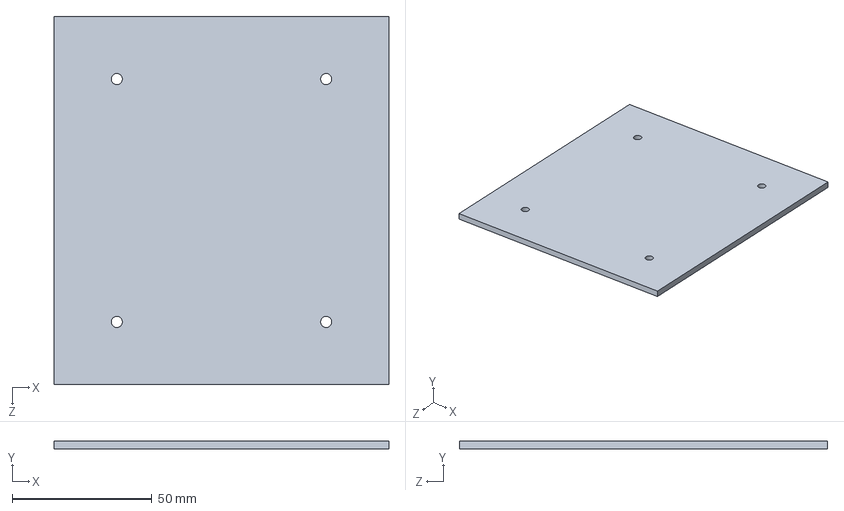
[picture p74: CAD file, 2022-10-15]
CAD_Designs/Prototype 2/Base.SLDPRT
120.0 x 3.00 x 132.0 mm
