KudoC0nan/Balance_On_Wheels/CAD_Designs/Prototype/Design File/Bearing axle.SLDPRT

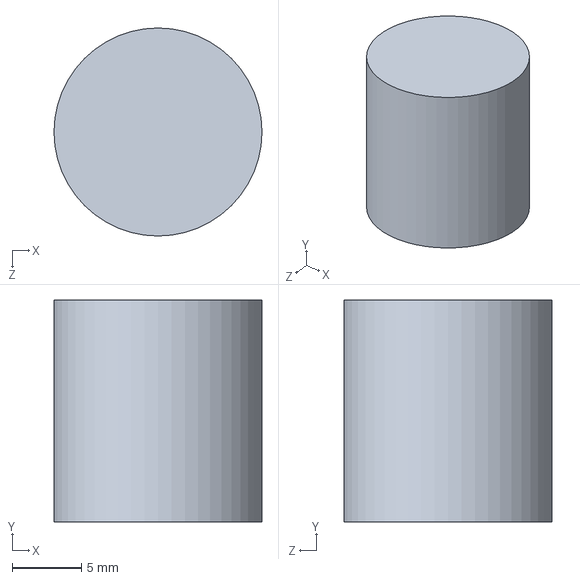
[picture p75: CAD file, 2022-10-15]
CAD_Designs/Prototype/Design File/Bearing axle.SLDPRT
15.0 x 16.0 x 15.0 mm
