KudoC0nan/Balance_On_Wheels/CAD_Designs/Prototype/Design File/Part1.SLDPRT

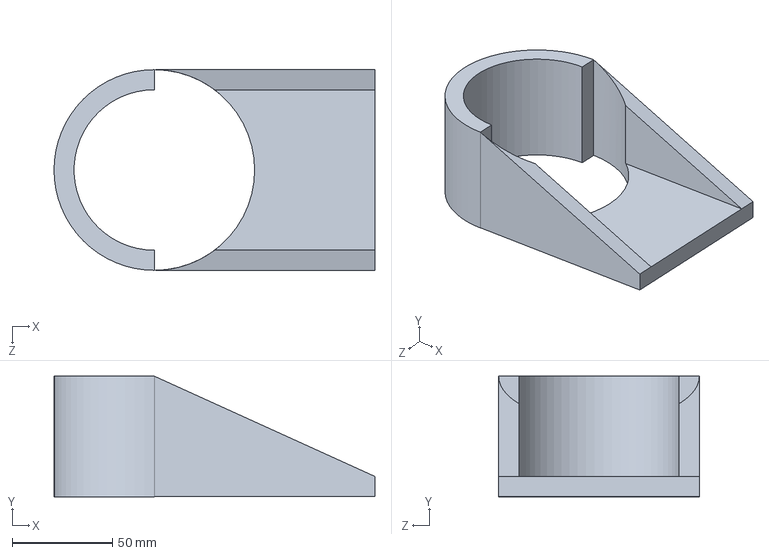
[picture p76: CAD file, 2022-10-15]
CAD_Designs/Prototype/Design File/Part1.SLDPRT
160.0 x 60.1 x 100.0 mm
