KudoC0nan/Balance_On_Wheels/CAD_Designs/Design For Lasercut (5mm)/5mm bot/L2 long(5mm).SLDPRT

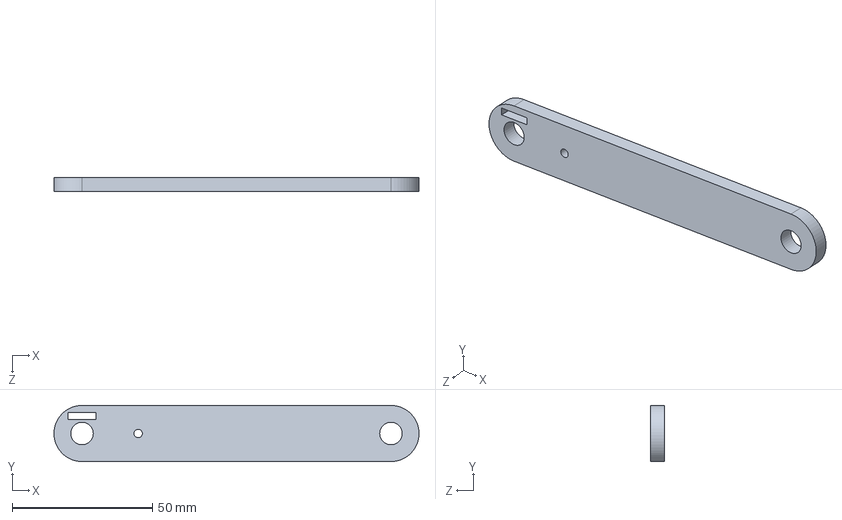
[picture p77: CAD file, 2022-10-15]
CAD_Designs/Design For Lasercut (5mm)/5mm bot/L2 long(5mm).SLDPRT
130.0 x 20.0 x 5.00 mm
