KudoC0nan/Balance_On_Wheels/CAD_Designs/Prototype/Design File/Gear_mount.SLDPRT

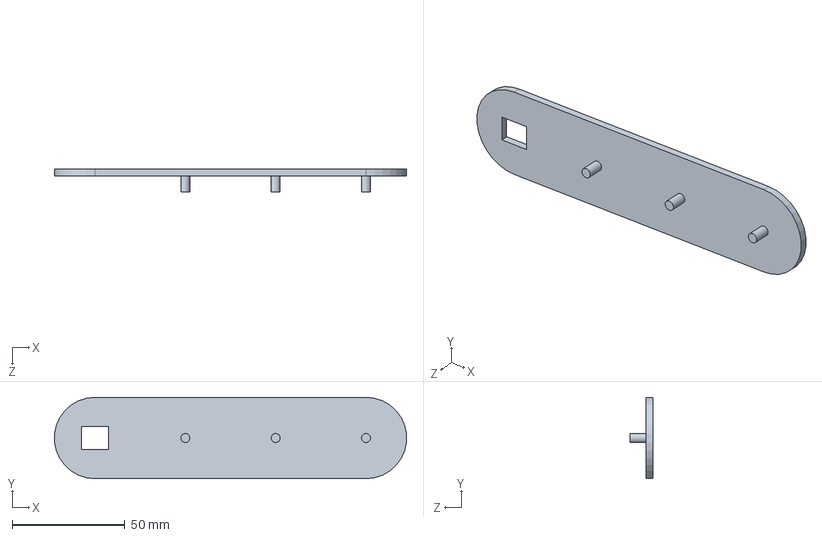
[picture p78: CAD file, 2022-10-15]
CAD_Designs/Prototype/Design File/Gear_mount.SLDPRT
155.8 x 36.0 x 10.0 mm
