KudoC0nan/Balance_On_Wheels/CAD_Designs/Prototype/Design File/Updated Leg Design 1.SLDPRT

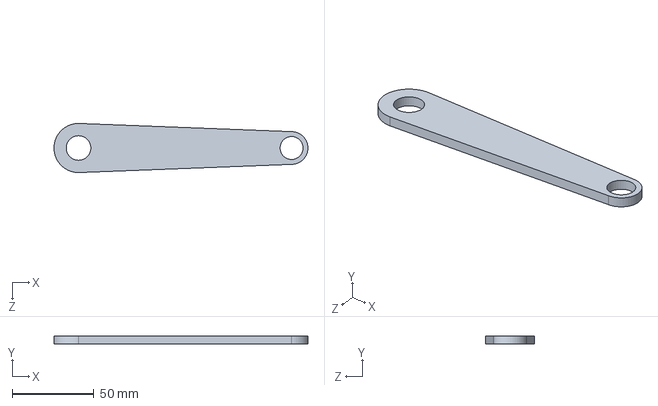
[picture p80: CAD file, 2022-10-15]
CAD_Designs/Prototype/Design File/Updated Leg Design 1.SLDPRT
155.0 x 5.00 x 30.0 mm
