KudoC0nan/Balance_On_Wheels/CAD_Designs/Design For Lasercut (5mm)/5mm bot/L1 new(5 mm).SLDPRT

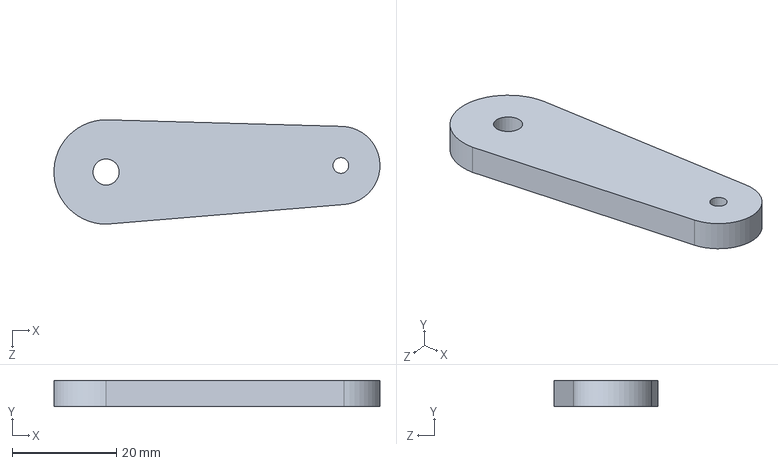
[picture p81: CAD file, 2022-10-15]
CAD_Designs/Design For Lasercut (5mm)/5mm bot/L1 new(5 mm).SLDPRT
62.5 x 5.00 x 20.0 mm
