KudoC0nan/Balance_On_Wheels/CAD_Designs/Prototype/Design File/Stopper.SLDPRT

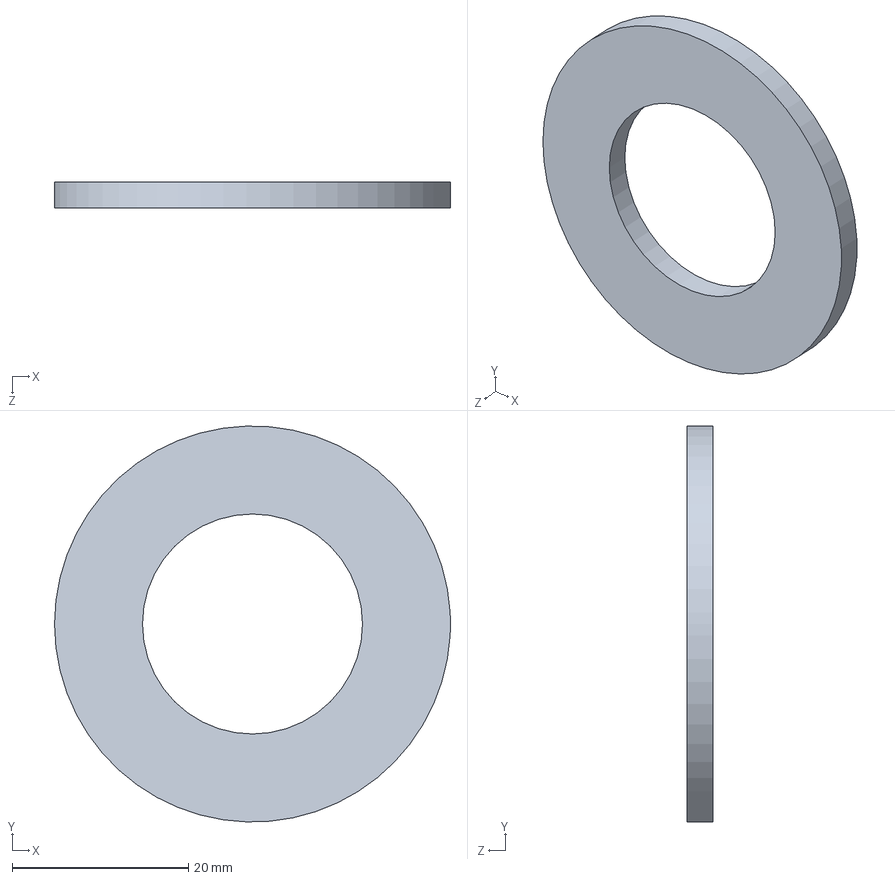
[picture p82: CAD file, 2022-10-15]
CAD_Designs/Prototype/Design File/Stopper.SLDPRT
45.0 x 45.0 x 3.00 mm
