KudoC0nan/Balance_On_Wheels/CAD_Designs/Prototype/Design File/SRA_board.SLDPRT

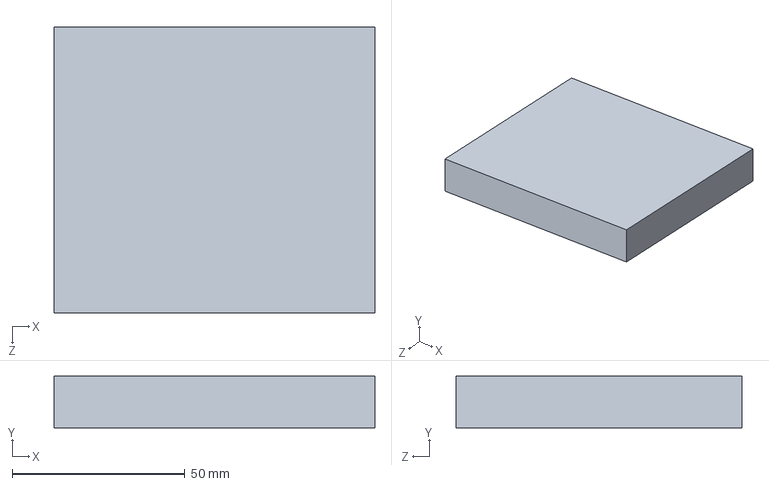
[picture p83: CAD file, 2022-10-15]
CAD_Designs/Prototype/Design File/SRA_board.SLDPRT
93.0 x 15.0 x 83.0 mm
