KudoC0nan/Balance_On_Wheels/CAD_Designs/Prototype/Design File/Motor base.SLDPRT

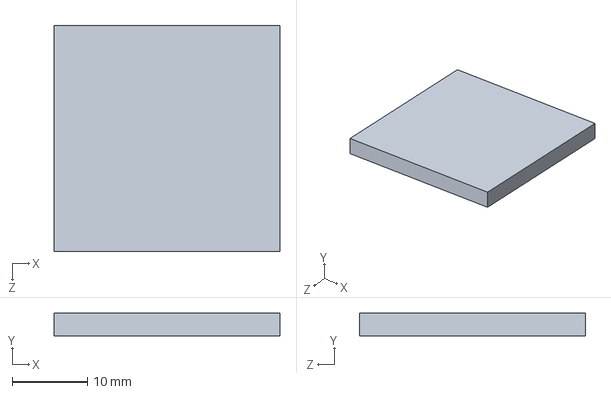
[picture p84: CAD file, 2022-10-15]
CAD_Designs/Prototype/Design File/Motor base.SLDPRT
30.0 x 3.00 x 30.0 mm
