KudoC0nan/Balance_On_Wheels/CAD_Designs/Prototype/Design File/Bot_eklavya.SLDPRT

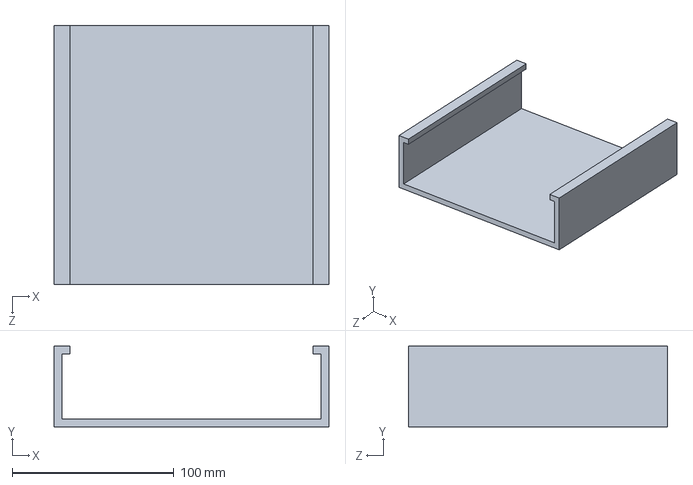
[picture p85: CAD file, 2022-10-15]
CAD_Designs/Prototype/Design File/Bot_eklavya.SLDPRT
170.0 x 50.0 x 160.0 mm
