KudoC0nan/Balance_On_Wheels/CAD_Designs/Prototype/Design File/Leg Design L1.SLDPRT

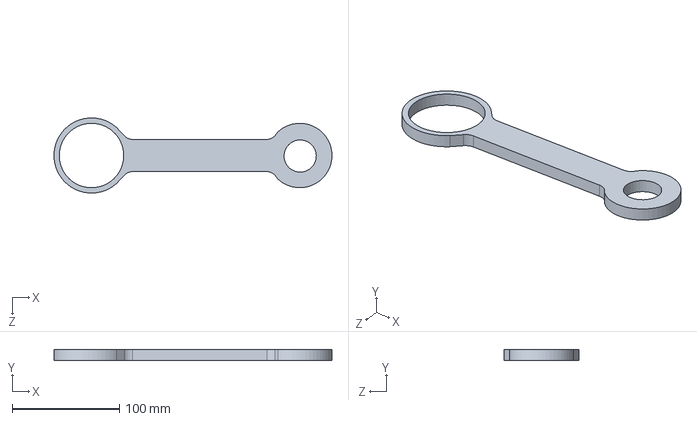
[picture p86: CAD file, 2022-10-15]
CAD_Designs/Prototype/Design File/Leg Design L1.SLDPRT
258.9 x 10.0 x 70.0 mm
