KudoC0nan/Balance_On_Wheels/CAD_Designs/Prototype/Design File/Real Wheel.SLDPRT

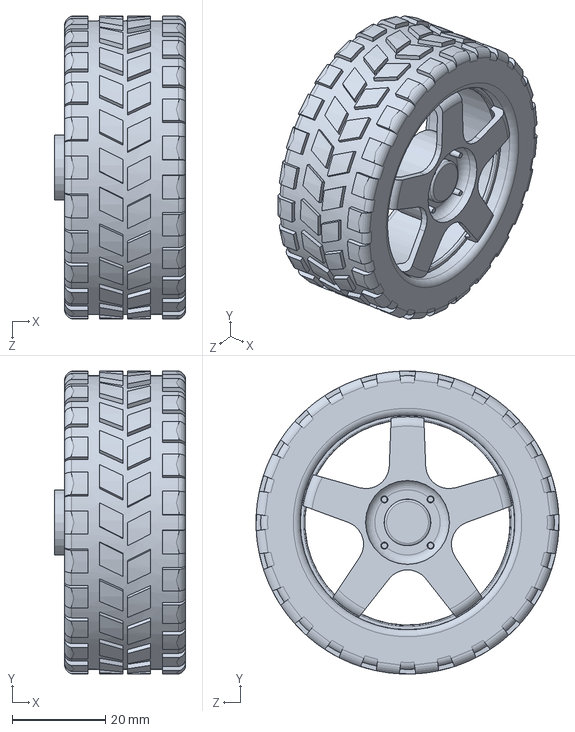
[picture p87: CAD file, 2022-10-15]
CAD_Designs/Prototype/Design File/Real Wheel.SLDPRT
28.2 x 65.0 x 65.0 mm
