KudoC0nan/Balance_On_Wheels/CAD_Designs/Prototype/Design File/gear_support.SLDPRT

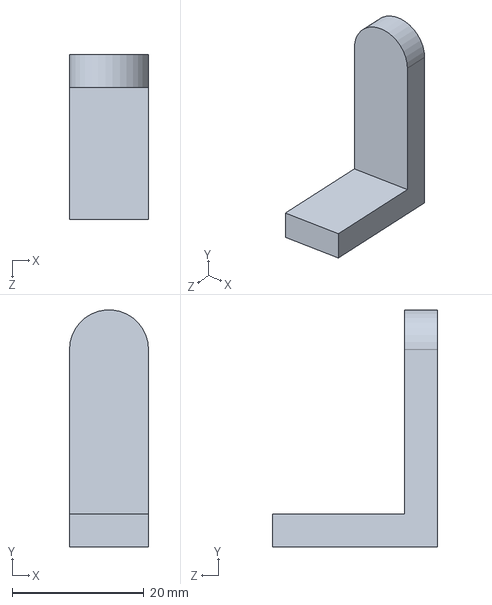
[picture p88: CAD file, 2022-10-15]
CAD_Designs/Prototype/Design File/gear_support.SLDPRT
12.0 x 36.0 x 25.0 mm
