KudoC0nan/Balance_On_Wheels/CAD_Designs/Prototype/Design File/motor stand.SLDPRT

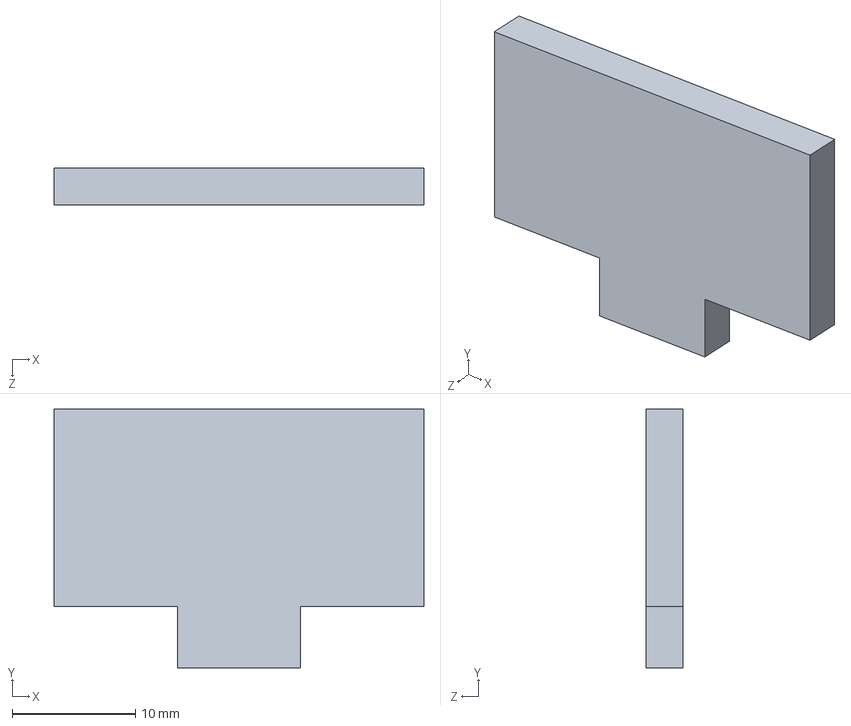
[picture p89: CAD file, 2022-10-15]
CAD_Designs/Prototype/Design File/motor stand.SLDPRT
30.0 x 21.0 x 3.00 mm
