KudoC0nan/Balance_On_Wheels/(list of files, cad)

Other CAD files:
CAD_Designs/Prototype/Design File/n20_motor.SLDPRT
CAD_Designs/Final Design For Laser Cut (3mm)/3mm/L1 new(3mm).SLDPRT
CAD_Designs/Final Design For Laser Cut (3mm)/3mm/Servo Mount(3mm).SLDPRT
CAD_Designs/Intermidiate Design/3 mm bot/Old Base 3mm thick.SLDPRT
CAD_Designs/Intermidiate Design/3 mm bot/Old L1 extended(3mm).SLDPRT
CAD_Designs/Intermidiate Design/3 mm bot/Old L1 new(3mm).SLDPRT
CAD_Designs/Intermidiate Design/3 mm bot/Old Long L2(3mm).SLDPRT
CAD_Designs/Intermidiate Design/3 mm bot/Old Prototype 3 (fully 3 mm).SLDASM
CAD_Designs/Intermidiate Design/3 mm bot/Old Prototype 3.SLDASM
CAD_Designs/Intermidiate Design/3 mm bot/OldAxle(3mm).SLDPRT
CAD_Designs/Intermidiate Design/5mm bot/Old Axle(5mm).SLDPRT
CAD_Designs/Intermidiate Design/5mm bot/Old Base 5 mm thick.SLDPRT
CAD_Designs/Intermidiate Design/5mm bot/Old L1 extended (5mm).SLDPRT
CAD_Designs/Intermidiate Design/5mm bot/Old L1 new(5 mm).SLDPRT
CAD_Designs/Intermidiate Design/5mm bot/Old L2 new(5mm).SLDPRT
CAD_Designs/Intermidiate Design/5mm bot/Old Lo.SLDPRT
CAD_Designs/Intermidiate Design/5mm bot/Old Long L2 with extrusion.SLDPRT
CAD_Designs/Intermidiate Design/5mm bot/Old Prototype 3 (fully 5 mm).SLDASM
CAD_Designs/Intermidiate Design/5mm(cut extrude n20 mount)/Axle CE OLD.SLDPRT
CAD_Designs/Intermidiate Design/5mm(cut extrude n20 mount)/Base CE OLD.SLDPRT
CAD_Designs/Intermidiate Design/5mm(cut extrude n20 mount)/L1 extended CE OLD.SLDPRT
CAD_Designs/Intermidiate Design/5mm(cut extrude n20 mount)/L1 new CE OLD.SLDPRT
CAD_Designs/Intermidiate Design/5mm(cut extrude n20 mount)/L2 new CE OLD.SLDPRT
CAD_Designs/Intermidiate Design/5mm(cut extrude n20 mount)/Prototype 3 (final) CE OLD.SLDASM
CAD_Designs/Intermidiate Design/5mm(cut extrude n20 mount)/Servo, Metal Gear, MG90S.step CE OLD.SLDPRT
CAD_Designs/Intermidiate Design/5mm(cut extrude n20 mount)/Short L2 CE OLD.SLDPRT
CAD_Designs/Intermidiate Design/5mm(cut extrude n20 mount)/servo mount CE OLD.SLDPRT
