KudoC0nan/Balance_On_Wheels/components/sra-board-component/u8g2/tools/buildcpp/display.csv

# 1. device name
# 2. pinset
# 3. constructor name w/o prefix
u8x8_d_ssd1306_128x64_noname | 4WSWSPI | SSD1306_128X64_4W_SW_SPI
u8x8_d_ssd1306_128x64_noname | 4WHWSPI | SSD1306_128X64_4W_HW_SPI
u8x8_d_ssd1306_128x64_noname | 3WSWSPI | SSD1306_128X64_3W_SW_SPI
u8x8_d_ssd1306_128x64_noname | SSDSWI2C | SSD1306_128X64_SW_I2C
u8x8_d_ssd1306_128x64_noname | 6800 | SSD1306_128X64_6800
u8x8_d_ssd1306_128x64_noname | 8080 | SSD1306_128X64_8080
