KudoC0nan/Balance_On_Wheels/(threads)

Thread 3 (2022-10-02):

File Structure for Project

Ayush-Kaura, 2022-10-02:
Structure your files along these lines with separate folders for

1.     assets folder (one in root directory and whereever required)
2.     model (contains your python scripts used for kinematic calculations, explanation + graph in Readme inside the folder can include underactuated, fully actuated to it as well) Pdf which @KudoC0nan on his branch is fine, Readme is not required for that much part
3.     CAD Design (Current CAD Folder is fine just label the one used as Final Design used for Laser Cut ( x mm))
4.     components folder required for esp-idf code (should not be inside any folder)
5.     examples for small functionalities like mpu, wifi logging, servo set zero, oled etc
6.     firmware/Main Code combining Jump + Self Balancing + Variable Height
7.     notes for whatever readme you have made like gpio, led blink, notes made by both should be committed maybe in separate folders)

`Imp points to note` :
1. Since you have not combined all three functionality yet upload its separate folders in example directory for now.
2. Also,build folder not be committed in each folder should not be committed. Look at what gitignore file does, .vscode also not to be committed.
3. Do not created unwanted folders like Only main.c files of examples.

For cleaning Develop branch, there should not be mutliple commits doing just delete files etc. Use co-author commits if required. Readme + Assets to be done on separate branch as mentioned in #2, notes can be done there as well, rest on Develop branch.

Ayush-Kaura, 2022-10-20:
Looks good for the most part.
Minor Nitpick:

- Remove unnecessary examples like and rename examples like 1_MPU test 2_Servo_Set_Zero, etc. You can also add example to calibrate mpu
- Improve readme
- Can add code to switch codes between jump and balance at variable height, can be done in code or using switch present on board
- Future Scope is to implement LQR, you can discuss this with me.

@Arsh-Khan @KudoC0nan

Closed 2023-02-20.
