KudoC0nan/Balance_On_Wheels/firmware/Self_Balance_Variable_Height/main/main.c

#include "sra_board.h"

#define TAG "MCPWM_SERVO_CONTROL"

servo_config servo_a = {
	.servo_pin = SERVO_A,
	.min_pulse_width = 500,
	.max_pulse_width = 3000,
	.max_degree = 180,
	.mcpwm_num = MCPWM_UNIT_0,
	.timer_num = MCPWM_TIMER_0,
	.gen = MCPWM_OPR_A,
};

servo_config servo_b = {
	.servo_pin = SERVO_B,
	.min_pulse_width = 500,
	.max_pulse_width = 3000,
	.max_degree = 180,
	.mcpwm_num = MCPWM_UNIT_0,
	.timer_num = MCPWM_TIMER_0,
	.gen = MCPWM_OPR_B,
};

servo_config servo_c = {
	.servo_pin = SERVO_C,
	.min_pulse_width = 500,
	.max_pulse_width = 3000,
	.max_degree = 180,
	.mcpwm_num = MCPWM_UNIT_0,
	.timer_num = MCPWM_TIMER_1,
	.gen = MCPWM_OPR_A,
};

servo_config servo_d = {
	.servo_pin = SERVO_D,
	.min_pulse_width = 500,
	.max_pulse_width = 3000,
	.max_degree = 180,
	.mcpwm_num = MCPWM_UNIT_0,
	.timer_num = MCPWM_TIMER_1,
	.gen = MCPWM_OPR_B,
};

static void servo_control(void *arg)
{
	enable_servo();

	while (1)
	{
		for (int i = 105,j=0; i>=0 && j<=105; i--,j++)
		{
			set_angle_servo(&servo_a, j);
			set_angle_servo(&servo_b, i);
			set_angle_servo(&servo_c, i);
			set_angle_servo(&servo_d, j);
			vTaskDelay(3);
		}
		for (int i = 0,j=105; i<=105 && j>=0; i++,j--)
		{
			set_angle_servo(&servo_a, j);
			set_angle_servo(&servo_b, i);
			set_angle_servo(&servo_c, i);
			set_angle_servo(&servo_d, j);
			vTaskDelay(3);
		}

	}
	vTaskDelete(NULL);
}

void servo_config_setting()
{
	xTaskCreate(&servo_control,"servo control",4096,NULL,1,NULL);
}
