KudoC0nan/Balance_On_Wheels/(commit log)

2022-09-03 Prototype 2 with n20 motor and small gear mount
    [Axle.SLDPRT, Base.SLDPRT, Gear mount.SLDPRT, L1 new.SLDPRT, L2 new.SLDPRT, Prototype 2.SLDASM]
2022-09-06 Create Readme.md
    Bot designs for 3mm and 5mm
2022-09-06 3mm bot with cut extruded base and n20 motor mount
    3mm bot with cut extruded base and n20 motor mount extruded from the leg
    [Axle(3mm).SLDPRT, Base 3mm thick.SLDPRT, L1 extended(3mm).SLDPRT, L1 new(3mm).SLDPRT, L2 new(3mm).SLDPRT, Long L2(3mm).SLDPRT, Prototype 3 (fully 3 mm).SLDASM, Prototype 3.SLDASM]
2022-09-06 5mm bot and different n20 motor mount
    [Axle(5mm).SLDPRT, Base 5 mm thick.SLDPRT, L1 extended (5mm).SLDPRT, L1 new(5 mm).SLDPRT, L2 new(5mm).SLDPRT, Lo.SLDPRT, Long L2 with extrusion.SLDPRT, Prototype 3 (fully 5 mm).SLDASM]
2022-09-06 5mm and 3mm bot and servo/motor mounts
2022-09-06 Servo Mount
    [Servo Mount.SLDPRT]
2022-09-06 3mm bot with cut extruded base and n20 motor mount
    [Servo, Metal Gear, MG90S.step.SLDPRT]
2022-09-06 5mm bot with cut extrude n20 mount
    [Axle.SLDPRT, Base.SLDPRT, L1 extended.SLDPRT, L1 new.SLDPRT, L2 new.SLDPRT, Prototype 3 (final).SLDASM, Real Wheel.SLDPRT, Servo, Metal Gear, MG90S.step.SLDPRT]
2022-09-06 5mm and 3mm bot designs with motor mounts
2022-09-07 Design for laser cutting
2022-09-07 3mm bot design to be given for laser cut
    [Axle for joint.SLDPRT, Base 3mm thick.SLDPRT, L1 extension.SLDPRT, L1 new(3mm).SLDPRT, L2 new(3mm).SLDPRT, Long L2(3mm).SLDPRT, Prototype 3 (fully 3 mm).SLDASM, Real Wheel.SLDPRT]
2022-09-08 Laser cutting designs/files for the 5mm bot
2022-09-09 Moved Previous Designs to another folder
    Moved Previous Designs to another folder named Intermidiate Designs from Final design.
    [Axle(3mm).SLDPRT, Axle(5mm).SLDPRT, Axle.SLDPRT, Base 3mm thick.SLDPRT, Base 5 mm thick.SLDPRT, Base.SLDPRT, L1 extended (5mm).SLDPRT, L1 extended(3mm).SLDPRT]
2022-09-09 Changed the name for 3mm laser cut design folder
    [Axle for joint.SLDPRT, Base 3mm thick.SLDPRT, L1 extension.SLDPRT, L1 new(3mm).SLDPRT, L2 new(3mm).SLDPRT, Long L2(3mm).SLDPRT, Prototype 3 (fully 3 mm).SLDASM, Real Wheel.SLDPRT]
2022-09-10 changed the design files
    changed the final assemblies for 5mm and 3mm bot along with the mounting holes for their bases for the sra board
    [Base 5 mm thick.SLDPRT, Prototype 3 (fully 3 mm).SLDASM, Prototype 3 (fully 5 mm).SLDASM]
2022-09-13 Edited the files to make them proper.
    Renamed the files and updated them.
    [Axle CE OLD.SLDPRT, Axle for joint(3mm).SLDPRT, Base 3mm thick.SLDPRT, Base CE OLD.SLDPRT, L1 extended CE OLD.SLDPRT, L1 extension(3mm).SLDPRT, L1 new CE OLD.SLDPRT, L1 new(3mm).SLDPRT]
2022-09-14 Added n20 motor file in final 3mm
    [n20_motor(3mm).SLDPRT]
2022-09-22 Added All the Design in CAD Designs Folder
    [Axle CE OLD.SLDPRT, Axle for joint(3mm).SLDPRT, Axle.SLDPRT, Base 3mm thick.SLDPRT, Base 5 mm thick.SLDPRT, Base CE OLD.SLDPRT, Base.SLDPRT, Bearing axle.SLDPRT]
2022-09-22 Deleted All Unecessary Files
    [Axle CE OLD.SLDPRT, Axle for joint(3mm).SLDPRT, Axle.SLDPRT, Base 3mm thick.SLDPRT, Base 5 mm thick.SLDPRT, Base CE OLD.SLDPRT, Base.SLDPRT, Bearing axle.SLDPRT]
2022-09-24 Changed files
    [board.dxf, clock.dxf, clock_2.dxf, clock_cube.dxf, display.csv, hx1230_commands.ods]
2022-10-04 Readme.md
    Removed current Readme.md and pushed the latest md to Documentation Branch
2022-10-04 Removing main.c folder
    [Axle for joint(3mm).SLDPRT, Base 3mm thick.SLDPRT, L1 extension(3mm).SLDPRT, L1 new(3mm).SLDPRT, L2 new(3mm).SLDPRT, Long L2(3mm).SLDPRT, Prototype 3 (fully 3 mm).SLDASM, Real Wheel(3mm).SLDPRT]
2022-10-04 Renamed Final Design Folders
    [Axle for joint(3mm).SLDPRT, Base 3mm thick.SLDPRT, L1 extension(3mm).SLDPRT, L1 new(3mm).SLDPRT, L2 new(3mm).SLDPRT, Long L2(3mm).SLDPRT, Prototype 3 (fully 3 mm).SLDASM, Real Wheel(3mm).SLDPRT]
2022-10-04 Removed Files Inside Examples
    [board.dxf, clock.dxf, clock_2.dxf, clock_cube.dxf, display.csv, hx1230_commands.ods]
2022-10-04 Added Components Files
    [board.dxf, clock.dxf, clock_2.dxf, clock_cube.dxf, display.csv, hx1230_commands.ods]
2022-10-04 Added Python Scripts for kinematic calculations and graph
2022-10-04 Updated exisiting code and added new ones.
    [board.dxf, clock.dxf, clock_2.dxf, clock_cube.dxf, display.csv, hx1230_commands.ods]
2022-10-10 Rename PID Explanation to PID Explanation.md
2022-10-14 Added Project Report
    [board.dxf, clock.dxf, clock_2.dxf, clock_cube.dxf, display.csv, hx1230_commands.ods]
2022-10-15 Removed Build Files
    [board.dxf, clock.dxf, clock_2.dxf, clock_cube.dxf, display.csv, hx1230_commands.ods]
2022-10-15 Update PID Explanation.md
